TiboLGH/solextronic/hardware/DCDC/DCDC.png

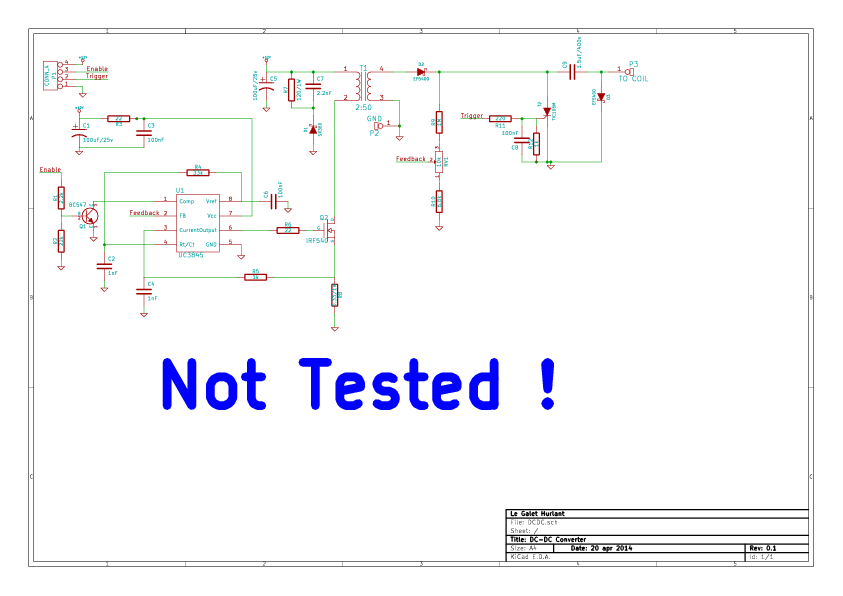
hardware/DCDC/DCDC.png
