TiboLGH/solextronic/hardware/DCDC/DCDC_brd.png

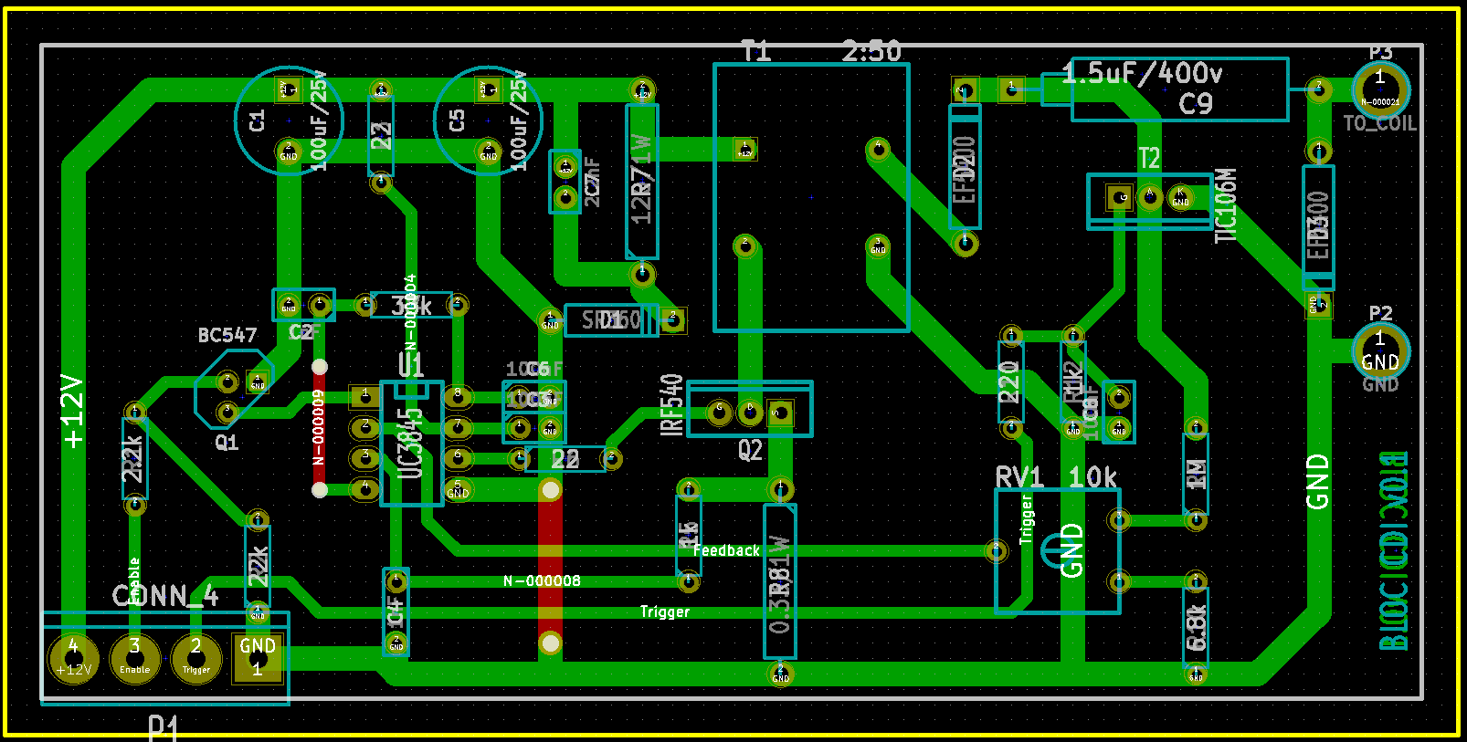
hardware/DCDC/DCDC_brd.png
