TiboLGH/solextronic/hardware/harness/harness.png

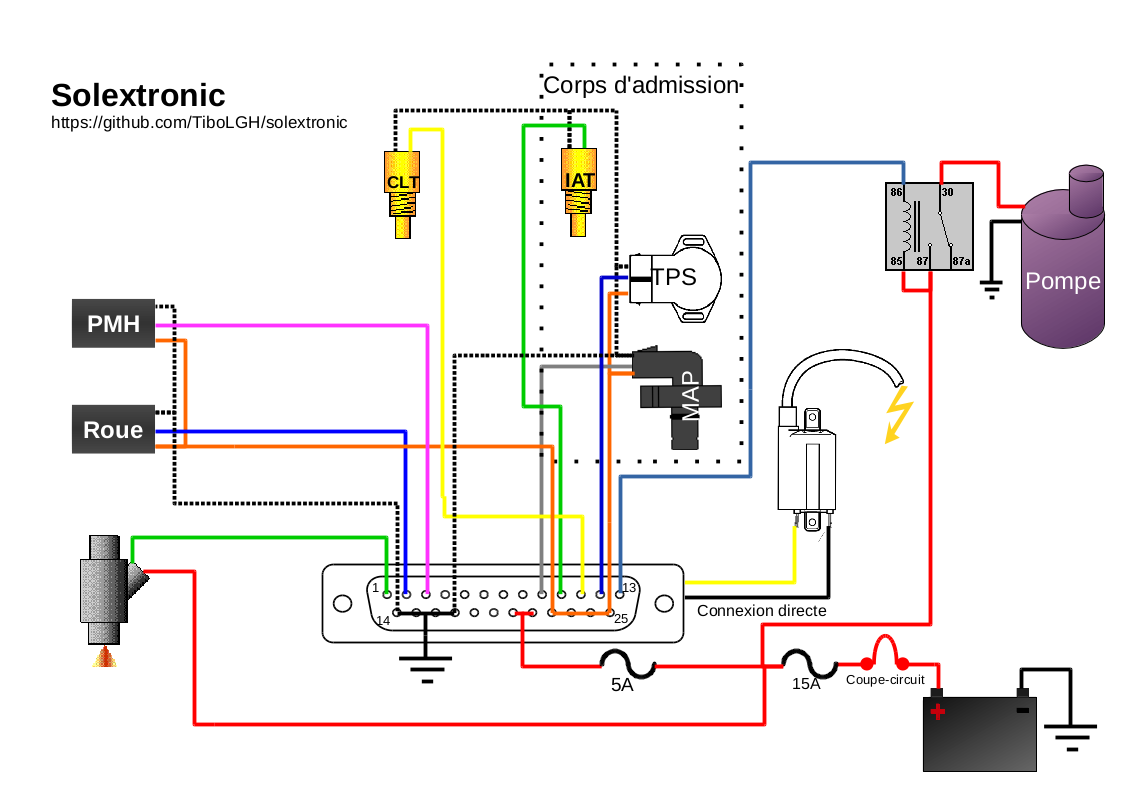
hardware/harness/harness.png
