TiboLGH/solextronic/hardware/solextronic.png

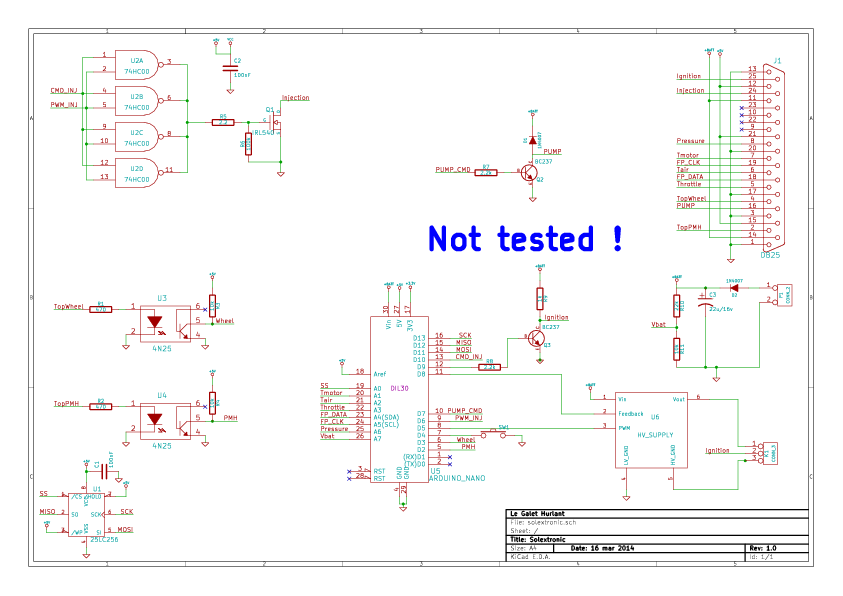
hardware/solextronic.png
