TiboLGH/solextronic/hardware/testBoard/testBoard.png

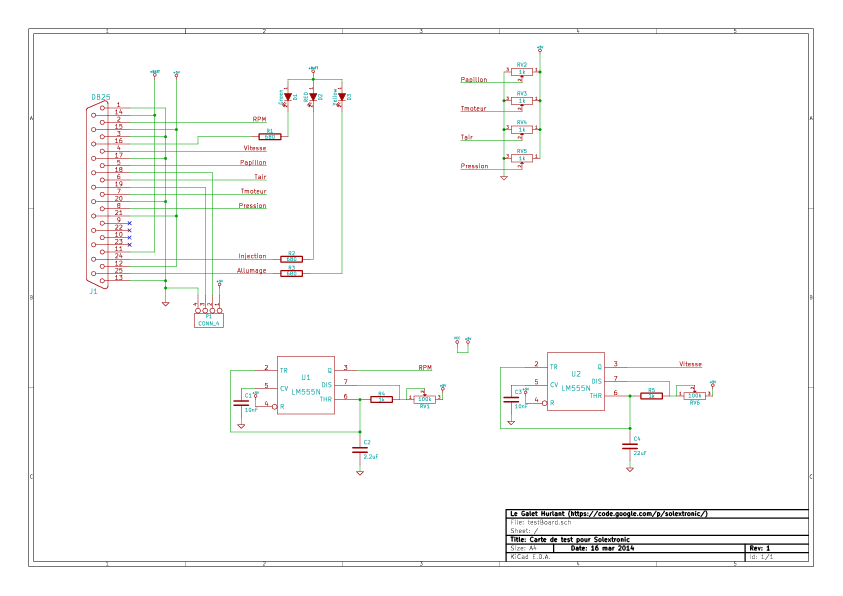
hardware/testBoard/testBoard.png
