TiboLGH/solextronic/(threads)

Thread 10 (2015-03-29):

Gestion des sorties injection/allumage avec un timing fixe

GoogleCodeExporter, 2015-03-29:
```
Dans le FW + test unitaire.

```

Original issue reported on code.google.com by `thibault...@gmail.com` on 18 Mar 2014 at 9:27

TiboLGH, 2015-08-07:
Done dans la version 0.2

Closed 2015-08-07.

Thread 17 (2015-03-29):

Support table de calibration temperature/pression

GoogleCodeExporter, 2015-03-29:
```
Pour supporter les capteurs de temperature de type CTN et le capteur de
pression, des tables de calibration doivent être gérées.

```

Original issue reported on code.google.com by `thibault...@gmail.com` on 11 Aug 2014 at 7:24

TiboLGH, 2015-06-14:
Done dans la rev edfa91a1de388214968415188e47ac5c28c51b85

Closed 2015-06-14.

Thread 18 (2015-03-29):

Support bornes/interpolation papillon

GoogleCodeExporter, 2015-03-29:
```
Pour supporter les variations du papillon, il faut supporter :
 - borne min
 - borne max
 - conversion tension -> 0-100%
 - detection plein gaz, ralenti

```

Original issue reported on code.google.com by `thibault...@gmail.com` on 11 Aug 2014 at 7:28

Closed 2015-07-06.

Thread 5 (2015-03-29):

Gestion centrale des conversions ADC

GoogleCodeExporter, 2015-03-29:
```
Indispensable pour le capteur de pression

```

Original issue reported on code.google.com by `thibault...@gmail.com` on 27 Jan 2014 at 9:12

Closed 2015-07-12.

Thread 9 (2015-03-29):

Schema du faisceau

GoogleCodeExporter, 2015-03-29:
```
+ carte d'adaptation analogique

```

Original issue reported on code.google.com by `thibault...@gmail.com` on 18 Mar 2014 at 9:23

TiboLGH, 2015-06-14:
Finalement, pas de carte d'adaptation analogique, on fait tout sur la carte principale.

TiboLGH, 2015-07-12:
commit c8f4fc2ebacf81f8e0f9d55c82d7b0f48d196261

Closed 2015-07-12.

Thread 21 (2015-07-12):

Gestion de la pompe a essence

TiboLGH, 2015-07-12:
La pompe doit être mise en route a l'appui sur le bouton de starter.
Elle se coupe sur les etats "calé" et "erreur".

TiboLGH, 2015-07-12:
commit f1423a43062c2caa1402921be4e6de4ca2cbf5d0

Closed 2015-07-12.

Thread 22 (2015-07-13):

Gestion du decalage capteur de PMH

TiboLGH, 2015-07-13:
Le code actuel suppose que le capteur de PMH est situé à 0 deg (parfaitement aligné avec le PMH). Pour faciliter l'installation, il est utile de pouvoir choisir le decalage de ce point PMH.

Thread 24 (2015-07-14):

Correction du dead time en fct de la tension de la batterie

TiboLGH, 2015-07-14:

Thread 25 (2015-08-03):

SIM define à la compilation

TiboLGH, 2015-08-03:
Certaines partie du FW ne sont pas (encore ?) simulables et doivent être désactivées et/ou simplifiées pour la simulation.
Exemple :
  * front panel sur I2C

TiboLGH, 2015-08-09:
Fix 539f6951e07a30fcd5a575639abae710855d7ce5

Closed 2015-08-09.

Thread 27 (2015-08-04):

Filtre fausse detection impulsion PMH

TiboLGH, 2015-08-04:
L'ensemble des timings d'injection et d'allumage reposent sur le signal de PMH (trigger). Il est donc fondamental que les eventuelles fausses detection soient filtrees.
Algo possible : la variation de periode d'un cycle à l'autre doit être inférieure à xx% de la durée du cycle (xx =20% pour commencer).

Thread 30 (2015-08-09):

Reparer la simulation

TiboLGH, 2015-08-09:
En incluant les tests auto:
 - ADC
 - test injection

TiboLGH, 2016-01-24:
Fixed e7e3c1fc556e9b67879100c116641bf804bb0966

Closed 2016-01-24.

Thread 31 (2016-01-27):

Nouveau test : demarrage complet

TiboLGH, 2016-01-27:
Pour ce test, on chercher à vérifier :
1/ Démarrage : verif alim HT et pompe
2/ cranking mode : timing injection/allumage au cranking en incluant les corrections temp/batterie
3/ passage en mode running : evolution des corrections + timing à chaque cycle

Thread 33 (2016-05-14):

Generation fichier VCD sur les structures eData et curData

TiboLGH, 2016-05-14:
Pour pouvoir tracer les structures eData (settings) et curData (etat courants) dans un fichier VCD avec la meme date de ref que le fichier VCD de la simultation.
Besoin également de pouvoir tracer des variables internes à la simulation (test number, steps...)

Closed 2016-06-05.

Thread 35 (2016-06-05):

SIM Gestion de l'UART dans un thread independant

TiboLGH, 2016-06-05:
Pour permettre une meilleure gestion des acces a l'uart dans la simulation.
3 taches:
 1/ main
 2/ thread simavr de la simulation
 3/ Acces UART

Les acces UART seront bloquants (+ timeout) pour le thread main + scheduler interne au thread UART pour faire des requetes en boucles.

Closed 2016-06-13.

Thread 37 (2016-12-14):

SIM - Systeme de logging centralise

TiboLGH, 2016-12-14:
Avec les features suivantes:
 - activation par modules
 - timestamp
 - niveaux debug, info, warning, error
 - redirection vers fichier txt
 - basé sur une seule interface

Exemple (C++) : http://www.drdobbs.com/cpp/logging-in-c/201804215?pgno=1

TiboLGH, 2016-12-30:
manque les timestamps

Thread 39 (2021-09-28):

Bonjour cher Français

AmesisProject, 2021-09-28:
Salut M. Je vien de tomber sur ton git. Je pense que nous avons a discuter tout les deux. Je fait un projet dans l'idée du tiens. mais je ne sais pas comment te contacter mise a par ici.
