TiboLGH/solextronic/hardware/solextronic.pdf

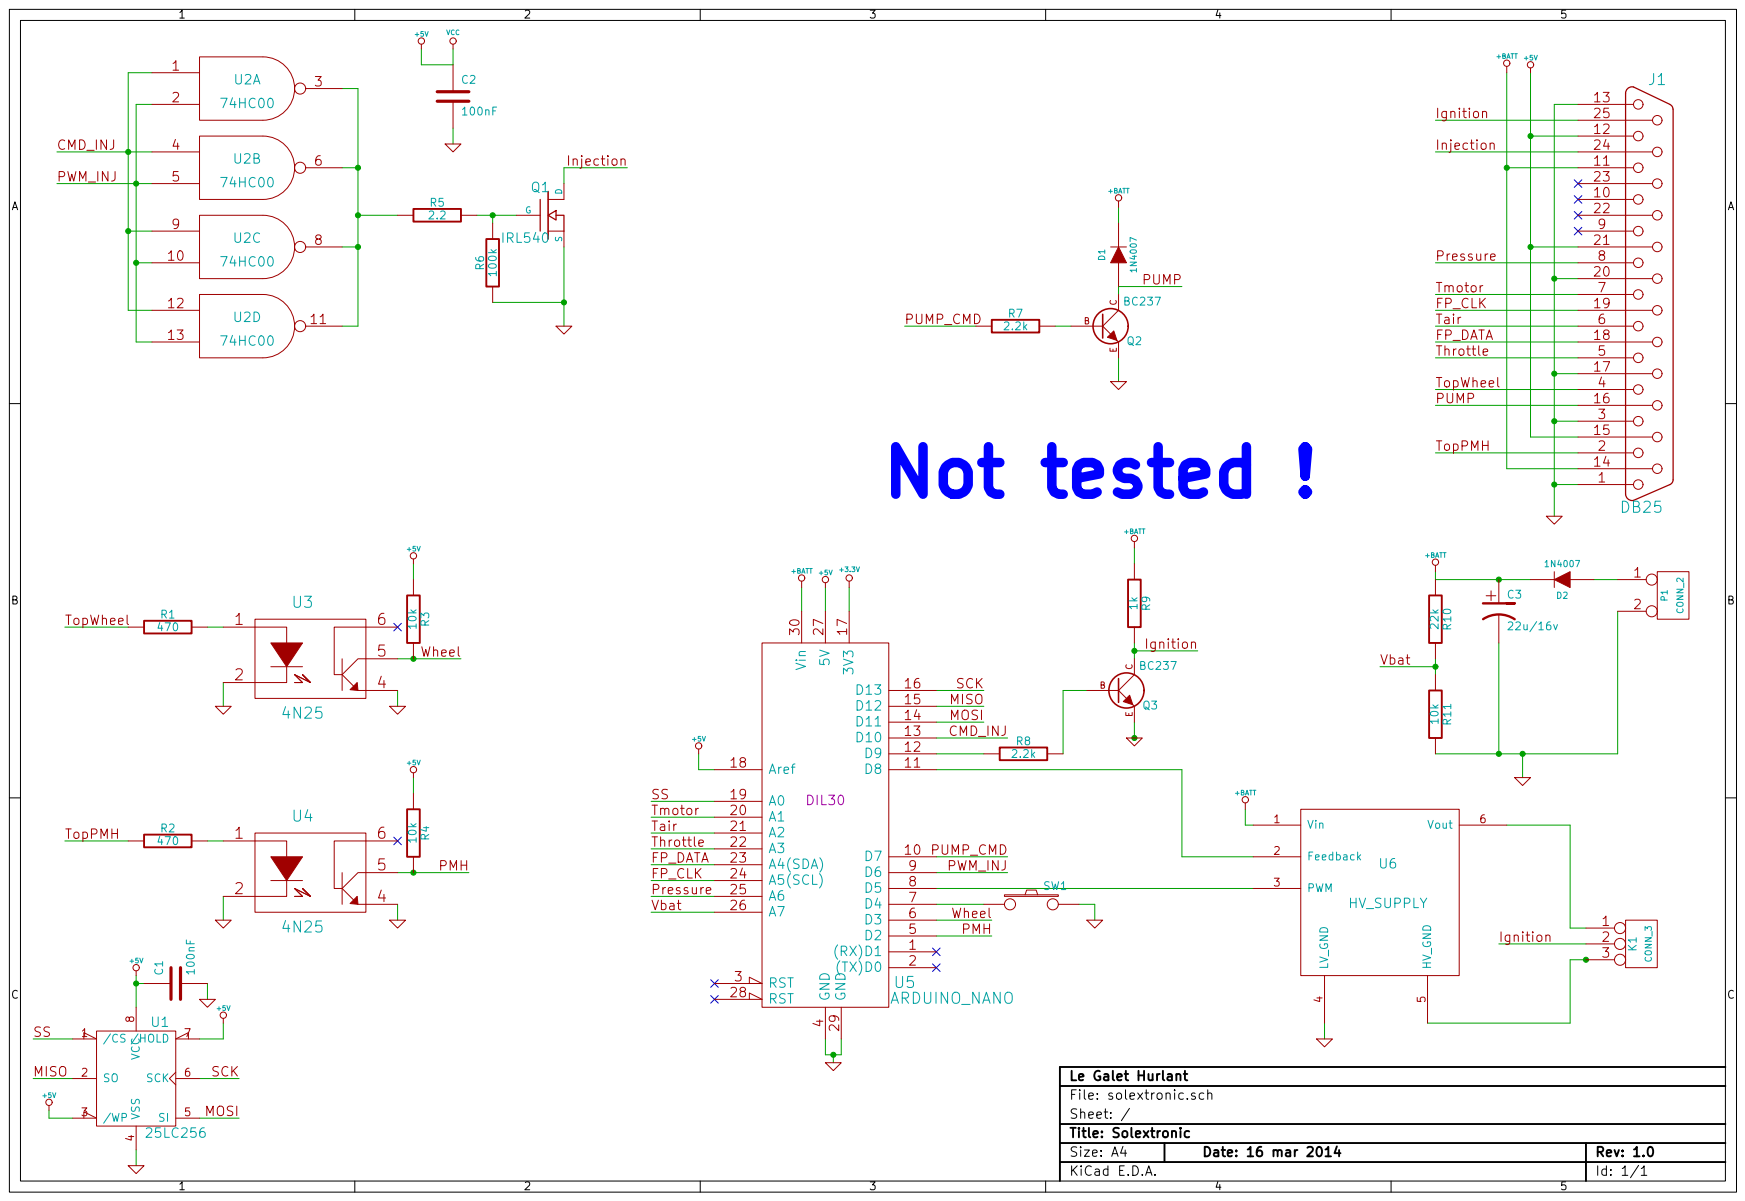
[picture p6: page 1]
