TiboLGH/solextronic/hardware/DCDC/DCDC.pdf

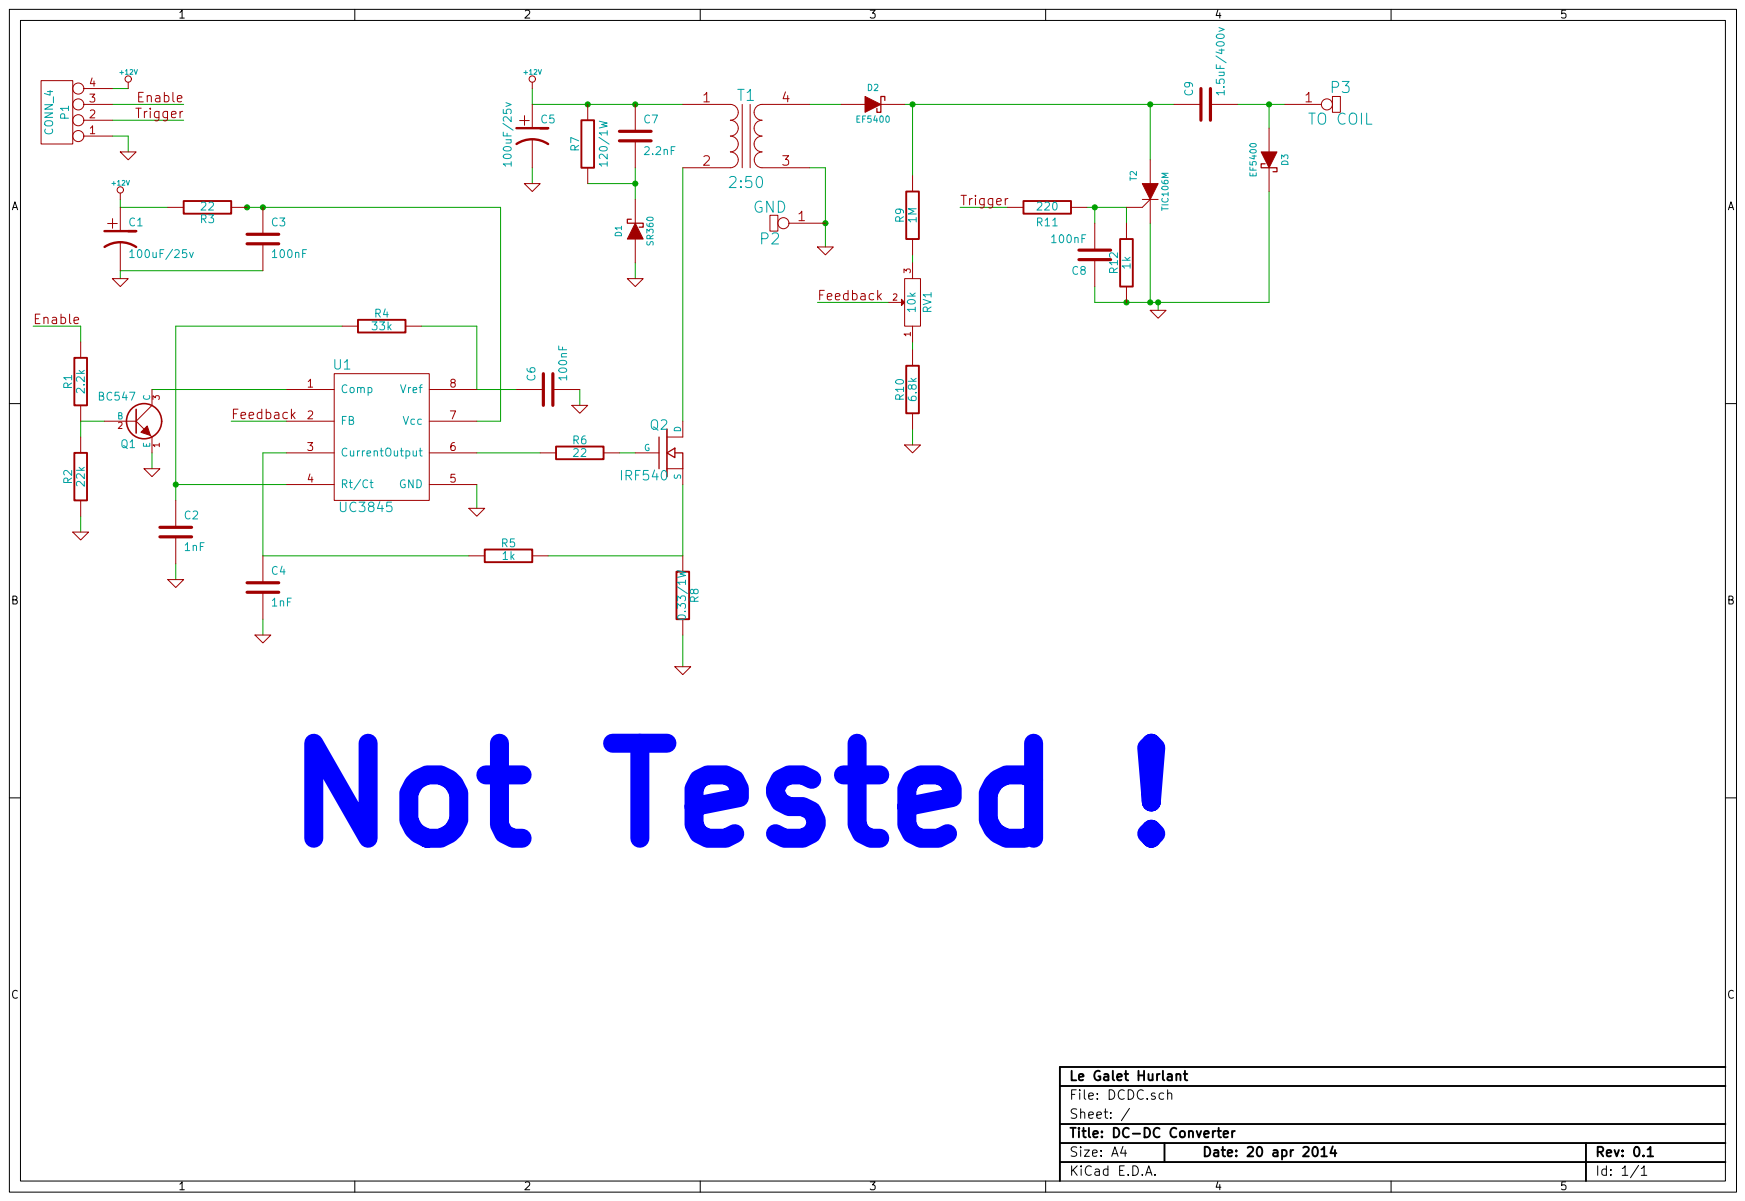
[picture p7: page 1]
