TiboLGH/solextronic/hardware/testBoard/testBoard.pdf

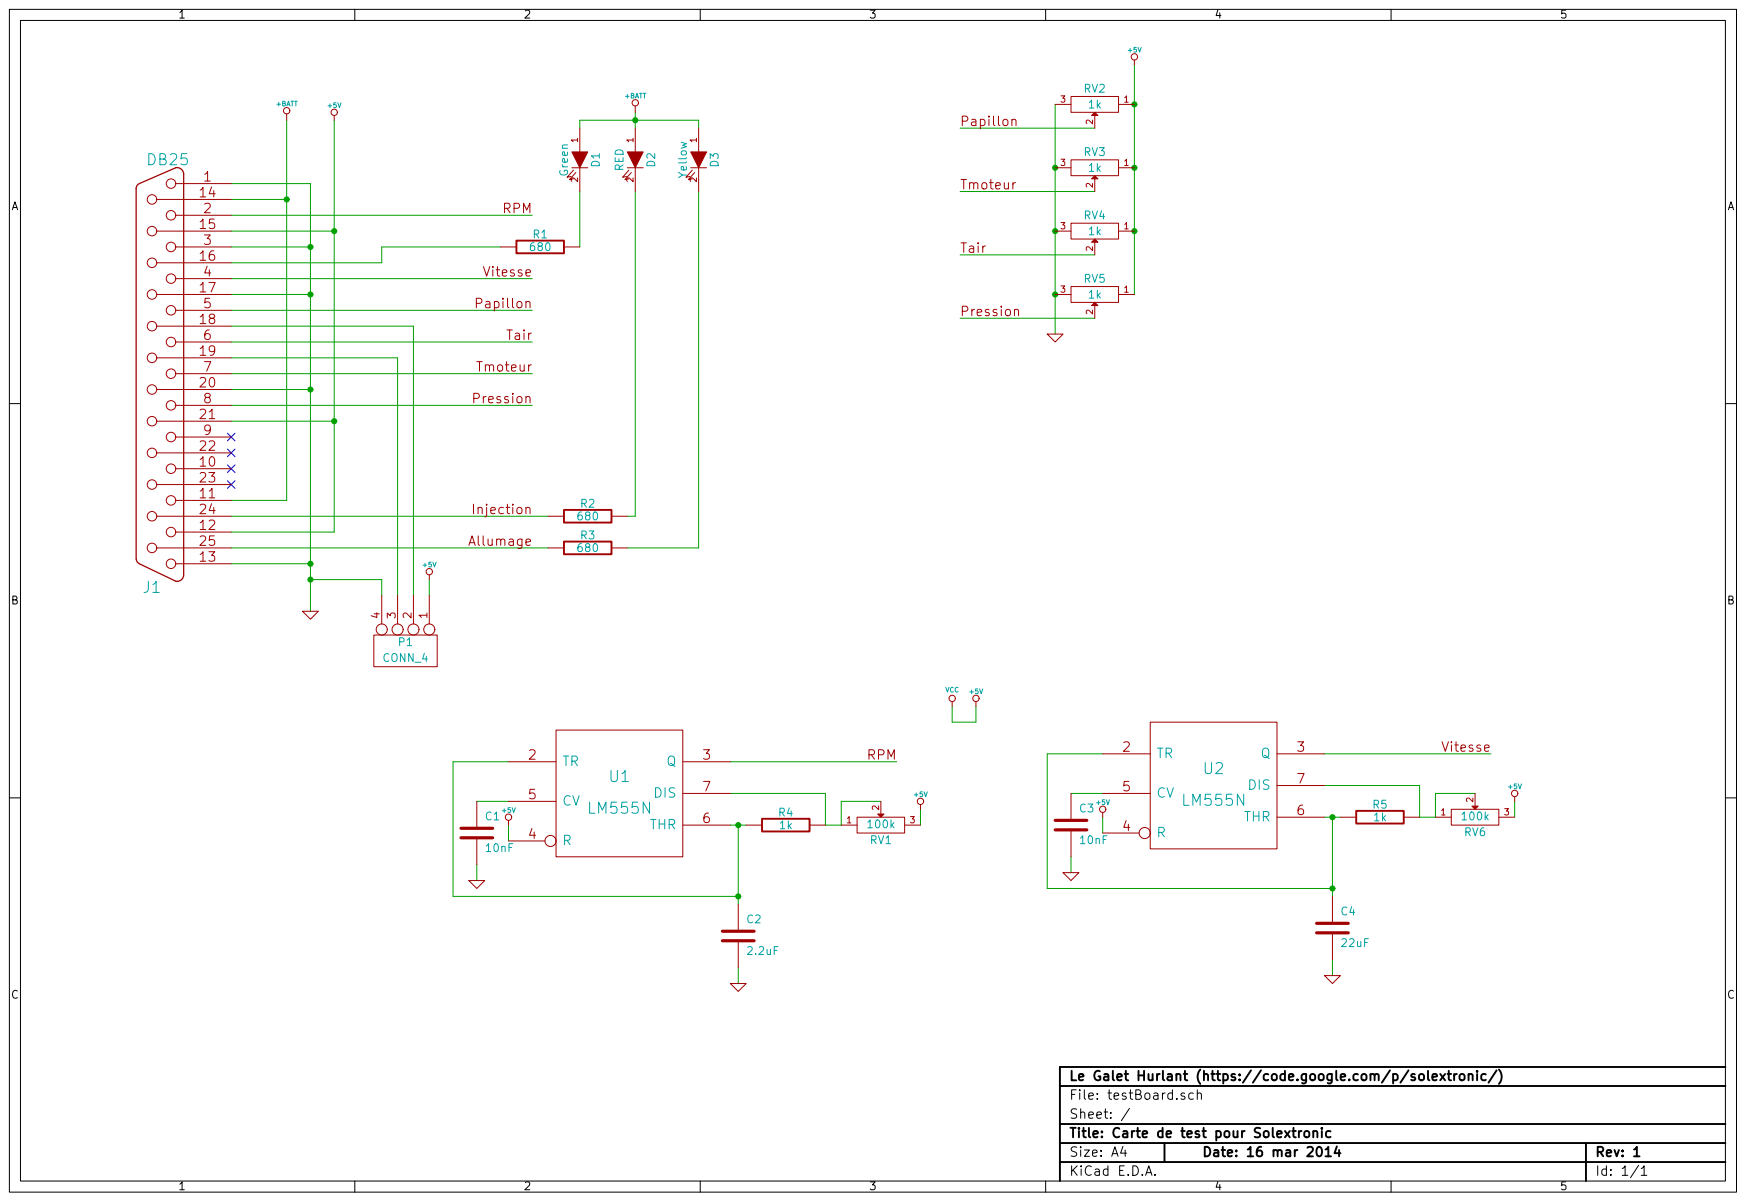
[picture p8: page 1]
