TiboLGH/solextronic/hardware/solextronic.kicad_pcb

## KiCad design hardware/solextronic.kicad_pcb (2015-03-29)

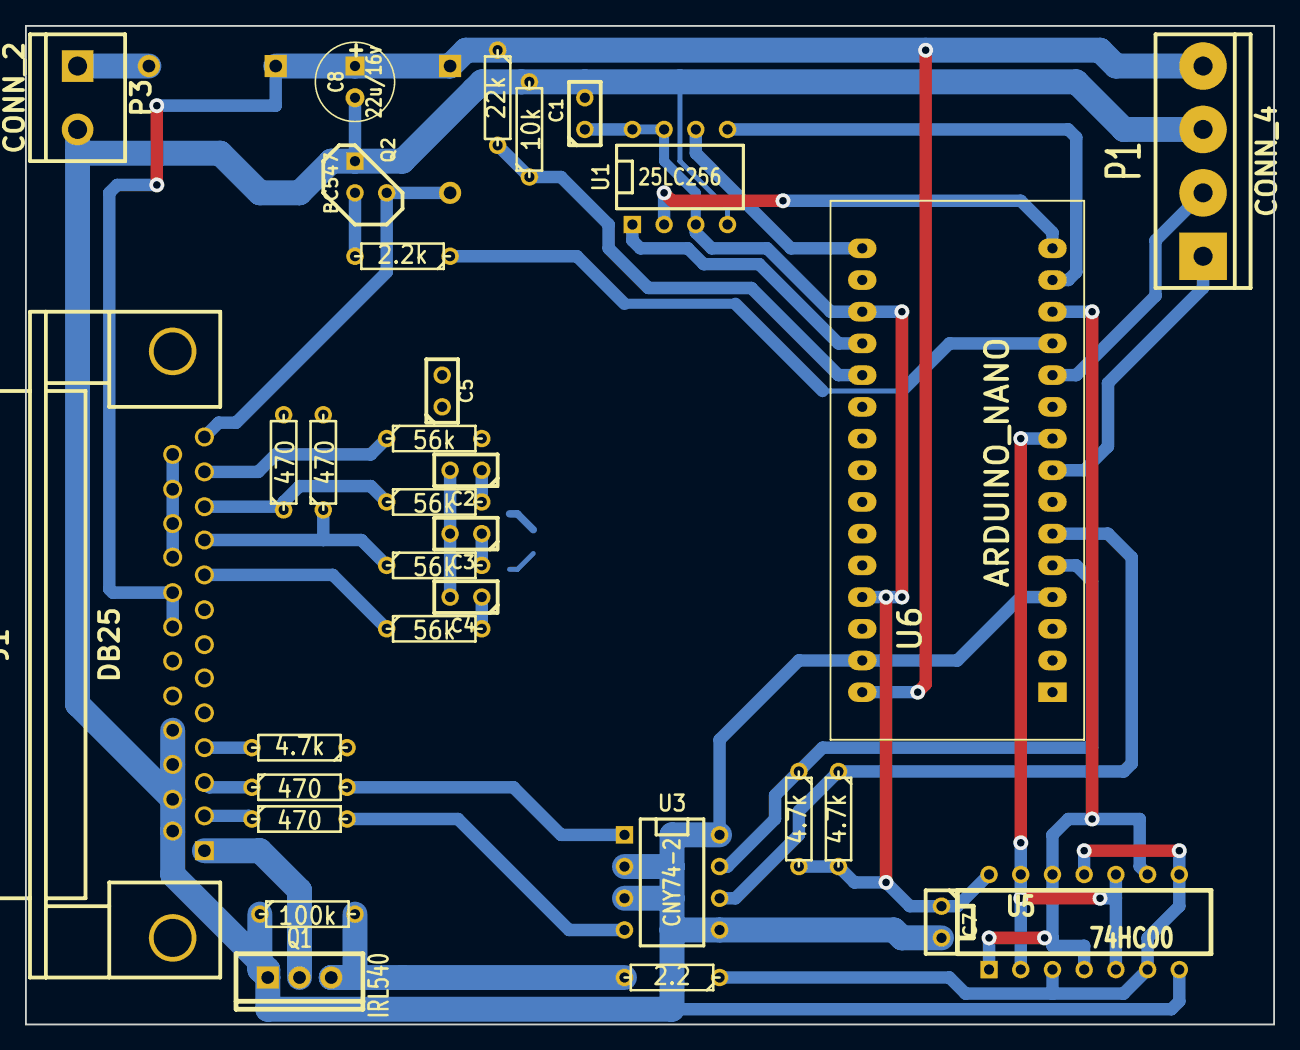
[picture p9: board solextronic.kicad_pcb from above]

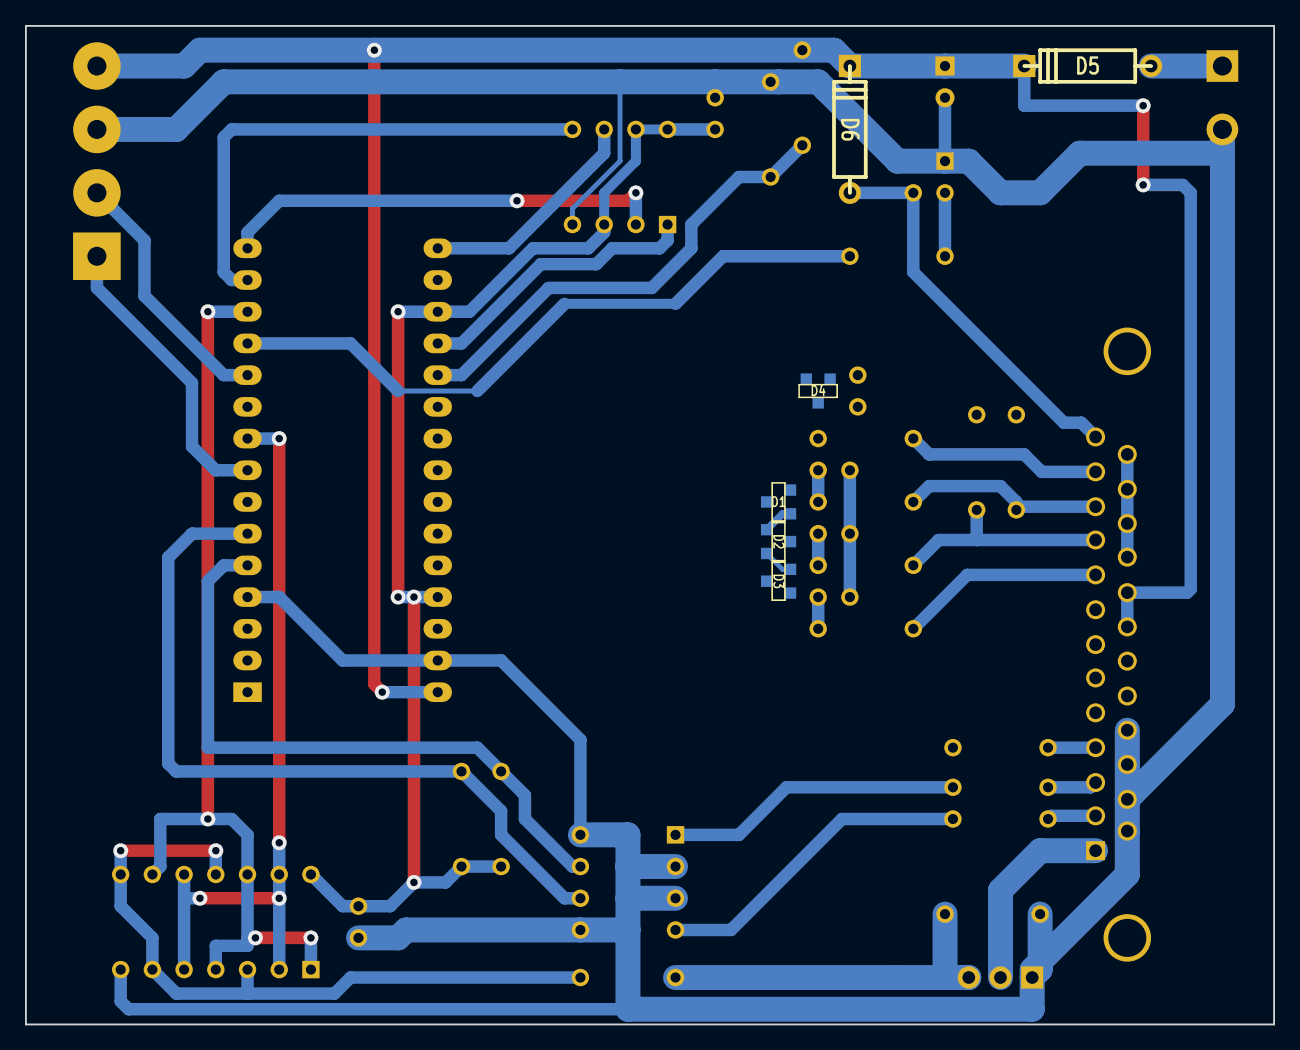
[picture p10: board solextronic.kicad_pcb from below]

Board: 2 copper layers, 100.0 x 80.0 mm, 38 parts (6 on the bottom side), 37 nets.

Parts:
C1, C2, C3, C4, C5, C7: 100nF; C1
C8: 22u/16v; C1V7
D1, D2, D3, D4: BAT54S; ST23AK#1
D5, D6: 1N4007; D4
J1: DB25; DB25FC
P1: CONN_4; bornier4
P3: CONN_2; bornier2
Q1: IRL540; TO220_VERT_GDS
Q2: BC547; TO92-EBC
R1, R3, R4, R16: 56k; R3
R2, R5, R6, R15: 470; R3
R7, R8, R11: 4.7k; R3
R9: 2.2; R3
R10: 100k; R3
R12: 22k; R3
R13: 10k; R3
R14: 2.2k; R3
U1: 25LC256; DIP-8__300
U3: CNY74-2; DIP-8__300
U5: 74HC00; DIP-14__300
U6: ARDUINO_NANO; arduino_nano

Connections:
+5V: C1.1, C7.1, D1.3, D2.3, D3.3, D4.3, J1.22, J1.23, J1.24, J1.25, R2.2, R7.2, R8.2, R11.1, R15.2, U1.3, U1.7, U1.8, U5.14, U6.18, U6.27
+BATT: C8.1, D5.2, D6.2, J1.20, J1.21, P1.4, R12.1, U6.30
/AUX1: J1.5, U6.10
/BTN1: J1.4, R11.2, U6.7
/CLT: J1.11, R1.1, R15.1
/CLTAdc: C2.1, D1.2, R1.2, U6.22
/CMD_INJ: U5.1, U5.4, U5.9, U5.12, U6.13
/EnableHV: P1.1, U6.8
/FP_CLK: J1.7, U6.24
/FP_DATA: J1.8, U6.23
/IAT: J1.10, R2.1, R3.1
/IATAdc: C3.1, D2.2, R3.2, U6.25
/Ignition: J1.6, P1.2, U6.11
/Injection: J1.1, Q1.D
/MAP: J1.9, R4.1
/MAPAdc: C4.1, D3.2, R4.2, U6.26
/MISO: U1.2, U6.15
/MOSI: U1.5, U6.14
/Motor: R8.1, U3.7, U6.5
/PUMP: D6.1, J1.13, Q2.C
/PUMP_CMD: R14.1, U6.12
/PWM_INJ: U5.2, U5.5, U5.10, U5.13, U6.9
/SCK: U1.6, U6.16
/SS: U1.1, U6.19
/TPS: J1.12, R16.1
/TPSAdc: C5.1, D4.2, R16.2, U6.21
/TopMotor: J1.3, R6.1
/TopWheel: J1.2, R5.1
/Vbat: R12.2, R13.1, U6.20
/Wheel: R7.1, U3.6, U6.6
GND: C1.2, C2.2, C3.2, C4.2, C5.2, C7.2, C8.2, D1.1, D2.1, D3.1, D4.1, J1.14, J1.15, J1.16, J1.17, P1.3, P3.2, Q1.S, Q2.E, R10.1, R13.2, U1.4, U3.2, U3.3, U3.5, U3.8, U5.7, U6.4, U6.29
unnamed: R9.1, U5.3, U5.6, U5.8, U5.11
unnamed: R6.2, U3.1
unnamed: D5.1, P3.1
unnamed: Q2.B, R14.2
unnamed: R5.2, U3.4
unnamed: Q1.G, R9.2, R10.2
