TiboLGH/solextronic/hardware/solextronic.sch

## KiCad design hardware/solextronic.sch (2015-07-19, an earlier design)

Schematic: solextronic.sch

Parts:
C1, C7: 100nF
C2, C3, C4, C5: 100nF
C8: 22u/16v
D1, D2, D3, D4: BAT54S
D5, D6: 1N4007
J1: DB25
P1, P2: CONN_4
P3: CONN_2
Q1: IRL540
Q2: BC547; TO92-EBC
R1, R2, R3: 56k
R4: 5.6k
R5, R6: 470
R7, R8, R11: 4.7k
R9: 2.2
R10: 100k
R12: 22k
R13: 10k
R14: 2.2k
R15, R16: 470
U1: 25LC256
U2: LM324
U3: CNY74-2
U5: 74HC00
U6: ARDUINO_NANO; DIL30

Notes on the sheet:
Not tested !
