TiboLGH/solextronic/hardware/DCDC/DCDC.sch

## KiCad design hardware/DCDC/DCDC.sch (2015-10-24, an earlier design)

Schematic: DCDC.sch

Parts:
C1, C5: 100uF/25v; C2V8
C2: 1nF; C1
C3, C6, C8: 100nF; C1
C4: 1nF; C2
C7: 2.2nF; C1
C9: 1.5uF/400v; CP10
D1: SR360; D4
D2, D3: EF5400; D5
P1: CONN_4; bornier4
P2: GND; 1pin
P3: TO COIL; 1pin
Q1: BC547; TO92
Q2: IRF540; TO220_VERT_GDS
R1: 2.2k; R3
R2: 22k; R3
R3, R6: 22; R3
R4: 33k; R3
R5, R12: 1k; R3
R7: 120/1W; R6
R8: 0.33/1W; R6
R9: 1M; R3
R10: 6.8k; R3
R11: 220; R3
RV1: 10k; POT
T1: 2:50; TRANSFO
T2: TIC106M; TIC106
U1: UC3845; DIP-8__300_ELL

Notes on the sheet:
Not Tested !
