TiboLGH/solextronic/hardware/testBoard/testBoard.sch

## KiCad design hardware/testBoard/testBoard.sch (2015-06-14, an earlier design)

Schematic: testBoard.sch

Parts:
C1, C3: 10nF
C2: 2.2uF
C4: 22uF
D1: Green
D2: RED
D3: Yellow
J1: DB25
P1: CONN_4
R1, R2, R3: 680
R4, R5: 1k
RV1, RV6: 100k
RV2, RV3, RV4, RV5: 1k
U1, U2: LM555N
