TiboLGH/solextronic/firmware/test/simMain.c

/***************************************************************************
 *   Copyright (C) 2013 by Thibault Bouttevin                              *
 *   thibault.bouttevin@gmail.com                                          *
 *   www.legalethurlant.fr.st                                              *
 *                                                                         *
 *   This file is part of SolexTronic                                      *
 *                                                                         *
 *   SolexTronic is free software; you can redistribute it and/or modify   *
 *   it under the terms of the GNU General Public License as published by  *
 *   the Free Software Foundation; either version 3 of the License, or     *
 *   any later version.                                                    *
 *                                                                         *
 *   This program is distributed in the hope that it will be useful,       *
 *   but WITHOUT ANY WARRANTY; without even the implied warranty of        *
 *   MERCHANTABILITY or FITNESS FOR A PARTICULAR PURPOSE.  See the         *
 *   GNU General Public License for more details.                          *
 *                                                                         *
 *   You should have received a copy of the GNU General Public License     *
 *   along with this program; if not, write to the                         *
 *   Free Software Foundation, Inc.,                                       *
 *   59 Temple Place - Suite 330, Boston, MA  02111-1307, USA.             *
 ***************************************************************************/
 /**
 * \file simMain.c
 * \brief Main file of the simulation
 * \author Thibault Bouttevin
 * \date June 2013
 *
 * This file includes the test scheduler and simaulation core based on simavr
 *
 */

#include <stdlib.h>
#include <stdio.h>
#include <libgen.h>
#include <string.h>
#include <stdbool.h>
#include <unistd.h>
#include <termios.h>
#include <ctype.h>
#include <sys/fcntl.h>
#include <pthread.h>

#include "sim_avr.h"
#include "avr_ioport.h"
#include "avr_timer.h"
#include "avr_adc.h"
#include "sim_elf.h"
#include "sim_gdb.h"
#include "sim_vcd_file.h"
#include "sim_irq.h"
#include "sim_time.h"

#include "uart_pty.h"
#include "pulse_input.h"
#include "analog_input.h"
#include "timing_analyzer.h"
#include "sim_helpers.h"
#include "trace_writer.h"
#include "push_button.h"
#include "logger.h"

#include "../varDef.h"
#include "../helper.h"
#include "../../model/model.h"

const char *ptyName = "/tmp/simavr-uart0";
#define RPM_QTY 5
#define SPEED_QTY 5
#define RETRY_SERIAL 3

#define RED(msg, ...) fprintf(stdout, "\033[31m" msg "\033[0m", ##__VA_ARGS__ )
#define GREEN(msg, ...) fprintf(stdout, "\033[32m" msg "\033[0m", ##__VA_ARGS__ )
#define HIGH(msg, ...) fprintf(stdout, "\033[1m" msg "\033[0m", ##__VA_ARGS__ )
#define V(msg, ...) if(_verbose) fprintf(stdout, msg, ##__VA_ARGS__ )

enum{
    MANUAL = 0,
    ALL_TEST,
    ONE_TEST,
    LIST_TEST,
};

enum{
    TEST_VERSION,
    TEST_RPM,
    TEST_SPEED,
    TEST_ANALOG,
    TEST_IGNTESTMODE,
    TEST_INJTESTMODE,
    TEST_TIMING,
    TEST_STARTING,
    TEST_QTY
};

enum{
    ERROR = 0,
    OK = 1,
    FAIL,
    PASS,
    NOTEST
};

typedef struct{
    int id;
    char name[256];
    int (*testFunction)(void);
}Test_t;

/*********************************
 * Thread architecture
 * 
 * 3 threads are used:
 *  1/ main fct as main thread driving the tests
 *  2/ simavr core simulation running in avr_run_thread() function
 *  3/ UART access tread running in uart_thread() function
 */

avr_t * avr = NULL;
avr_vcd_t vcd_file;
trace_writer_t vcd_trace;
int logHandle = -1;
uart_pty_t uart_pty;
pulse_input_t pulse_input_engine;
pulse_input_t pulse_input_wheel;
timing_analyzer_t timing_analyzer_injection;
timing_analyzer_t timing_analyzer_ignition;
analog_input_t analog;
button_t button_cranking;
volatile uint8_t    display_pwm = 0;
int fd = 0; /* access to serial port */
/* Thread messaging structure and shared variables */
typedef struct 
{
    eeprom_data_t    eData, eDataToWrite;
    current_data_t   gState;
    u8               signature[32];
    u8               revision[20];

    bool edata_read_request;
    bool edata_write_request;
    bool curdata_read_request;
    bool signature_read_request;
    bool continuous_mode;
    int status;

    pthread_mutex_t mutex_edata;
    pthread_cond_t  cond_uart_request;
    pthread_cond_t  cond_read_current_data;
    pthread_cond_t  cond_read_signature;
    pthread_cond_t  cond_write_edata;
    pthread_cond_t  cond_read_edata;
}uart_com_t;
static uart_com_t uart_com =
{
    .edata_read_request         = false,
    .edata_write_request        = false,
    .continuous_mode            = false,
    .curdata_read_request       = false,
    .signature_read_request     = false,
    .status                     = OK,   
    .mutex_edata                = PTHREAD_MUTEX_INITIALIZER,
    .cond_uart_request          = PTHREAD_COND_INITIALIZER,
    .cond_read_current_data     = PTHREAD_COND_INITIALIZER,
    .cond_read_signature        = PTHREAD_COND_INITIALIZER,
    .cond_write_edata           = PTHREAD_COND_INITIALIZER,
    .cond_read_edata            = PTHREAD_COND_INITIALIZER,
};

bool             _verbose = false;
bool             _wave    = false;

/* Forward declaration */
int TestVersion(void);
int TestRPM(void);
int TestSpeed(void);
int TestAnalog(void);
int TestIgnitionTestMode(void);
int TestInjectionTestMode(void);
int TestIgnInjTiming(void);
int TestStarting(void);
int TestStub(void);

int testQty;
Test_t testList[] = {
    {TEST_VERSION,      "Version",          TestVersion},
    {TEST_RPM,          "RPM",              TestRPM},
    {TEST_SPEED,        "Speed",            TestSpeed},
    {TEST_ANALOG,       "Analog",           TestAnalog},
    {TEST_IGNTESTMODE,  "IgnitionTest",     TestIgnitionTestMode},
    {TEST_INJTESTMODE,  "InjectionTest",    TestInjectionTestMode},
    {TEST_TIMING,       "Timing",           TestIgnInjTiming},
    {TEST_STARTING,     "Starting",         TestStarting},
};

/********* Helpers ************/
static void RPMtoPeriod(const uint32_t rpm, uint32_t *tHigh, uint32_t *tLow)
{
    *tHigh = 100; /* set high duration to 100us */
    if(rpm == 0)
        *tLow =0;
    else
        *tLow  = (uint32_t)(1000000. / (rpm / 60.) - *tHigh);
}

static void SpeedtoPeriod(const uint32_t speed, uint32_t *tHigh, uint32_t *tLow)
{
    *tHigh = 1000; /* set high duration to 1ms */
    if(speed == 0)
        *tLow =0;
    else
        *tLow  = 1000000 / (speed / 3.6 / 1.82) - *tHigh; /* 1.82m : for 19" wheel */
}

static float BatToVoltage(const float battery)
{
    return ((battery-7) / 30.);  //-0.7 for protection diode, BattRatio shall be set to 150
}

enum {IAT = 0, CLT};

static float TempToVoltage(const float degree, int type, eeprom_data_t *eData) // 0 IAT, 1 CLT
{
    // Reverse table to get adc value vs temp
    volatile u8 tempTable[TABSIZE][2];
    for(int i=0; i < TABSIZE; i++)
    {
        tempTable[TABSIZE-1 - i][0] = (type == IAT) ? eData->iatCal[i][1] : eData->cltCal[i][1];
        tempTable[TABSIZE-1 - i][1] = (type == IAT) ? eData->iatCal[i][0] : eData->cltCal[i][0];
    }
    u8 adc = Interp1D(tempTable, (u8)degree);
    //u8 temp = Interp1D(eData.iatCal, adc);
    //V("Type %s : %f deg -> %d adc -> %d deg\n", (type == IAT) ? "IAT":"CLT", degree, adc, temp);

    return (adc * 5 / 256.);
}

static float MapToVoltage(const float kpa, eeprom_data_t *eData) // considering linear based on min/max
{
    float voltage = (kpa + eData->map0) * 5 / (eData->map5 - eData->map0) ;
    return voltage;
}

static float ThrToVoltage(const float TPS, eeprom_data_t *eData) // TPS in %
{
    // note that TPS min and max are in ADC unit, not in %
    float adc = (eData->tpsMax - eData->tpsMin) * TPS / 100. + eData->tpsMin;
    float voltage = adc * 5/256.;
    return voltage;
}

typedef struct {
    unsigned int ledPin  : 1; // PB5
    unsigned int auxPin  : 1; // PB0
    unsigned int injPin  : 1; // PB2
    unsigned int ignPin  : 1; // PB1
    unsigned int pumpPin : 1; // PD7
    unsigned int hvPin   : 1; // PD5
}output_t;

// Get outputs states and return it as a bitfield
// if bug is not null, format a pretty print (need at least 256 bytes)
static output_t GetOutputState(char* buf)
{
    output_t state;
	avr_ioport_state_t iostate;
    // port B
    avr_ioctl(avr, AVR_IOCTL_IOPORT_GETSTATE('B'), &iostate);
    state.ledPin = (iostate.pin >> 5) & 0x1;
    state.auxPin = (iostate.pin >> 0) & 0x1;
    state.injPin = (iostate.pin >> 2) & 0x1;
    state.ignPin = (iostate.pin >> 1) & 0x1;
    // port D
    avr_ioctl(avr, AVR_IOCTL_IOPORT_GETSTATE('D'), &iostate);
    state.pumpPin = (iostate.pin >> 7) & 0x1;
    state.hvPin   = (iostate.pin >> 5) & 0x1;
    
    if(buf) // for pretty print
    {
        snprintf(buf, 256, "Led %s, Aux %s, Inj %s, Ign %s, Pump %s, HV %s", state.ledPin?"ON":"OFF",
                                                                             state.auxPin?"ON":"OFF",
                                                                             state.injPin?"ON":"OFF",
                                                                             state.ignPin?"ON":"OFF",
                                                                             state.pumpPin?"ON":"OFF",
                                                                             state.hvPin?"ON":"OFF"); 
    }


    return state;
}

// Engine state pretty print (need to be resynchronize with FW sometimes)
// buffer shall be at least 64 bytes
enum
{
    M_STOP      = 0,
    M_CRANKING  = 1 << 0,
    M_RUNNING   = 1 << 1,
    M_OVERHEAT  = 1 << 2,
    M_ERROR     = 1 << 3,
    M_STALLED   = 1 << 4,
    M_TEST_IGN  = 1 << 5,
    M_TEST_INJ  = 1 << 6,
    M_TEST_RUN  = 1 << 7
};
const char* engineStr[] = {
    "CRANKING",
    "RUNNING",
    "OVERHEAT",
    "ERROR",
    "STALLED",
    "TEST_IGN",
    "TEST_INJ",
    "TEST_RUN",
};
static void EnginePrettyPrint(u8 state, char* buf)
{
    if(state == M_STOP)
    {
        snprintf(buf, 64, "STOP");
    }else{
        // can have several bits active
        buf[0] = '\0';
        for(int i=0;i<8;i++)
        {
            if(buf[0] == '\0')
            {
                if((state >> i) & 1) sprintf(buf, "%s", engineStr[i]);
            }else{
                if((state >> i) & 1) sprintf(buf, "%s | %s", buf, engineStr[i]);
            }
        }
    }
    return;
}

#if 0
static void PrintArray(const u8* buffer, const int len)
{
    char str[1024];
    sprintf(str, "Len : %d, 0x", len);
    for(int i = 0; i < len; i++) sprintf(str, "%s %02X", str, *(buffer + i));
    V("%s\n", str);
    return;
}

static void PrettyPrint(const u8* buffer, const int len)
{
    char str[1024];
    sprintf(str, "Len : %d, 0x", len);
    for(int i = 0; i < len; i++) sprintf(str, "%s %d", str, *(buffer + i));
    V("%s\n", str);
    return;
}
#endif

static float TimingToAdvance(const uint32_t rpm, const uint32_t timing)
{
    // timing in us
    double period = 60e6/rpm; //us
    return (360 - (timing / period) * 360);
}

static bool CheckTolerance(const float result, const float expected, const float tolerance, float *error)
{
    *error = (result-expected);
    if(*error > tolerance || *error < -tolerance) return false;       
    return true;
}

/*********************************************************************/

static int SerialOpen(void)
{
    // from http://www.tldp.org/HOWTO/Serial-Programming-HOWTO/x115.html
    struct termios oldtio,newtio;
    int fd_s = 0;

    fd_s = open(ptyName, O_RDWR | O_NOCTTY ); 
    if (fd_s < 0) {perror(ptyName); exit(-1); }

    tcgetattr(fd_s, &oldtio); /* save current serial port settings */
    bzero(&newtio, sizeof(newtio)); /* clear struct for new port settings */
    newtio.c_cflag = B57600 | CS8 | CLOCAL | CREAD;
    newtio.c_iflag = IGNPAR; // | ICRNL | IGNCR;
    newtio.c_oflag = 0;
    newtio.c_lflag = 0; //ICANON;
    newtio.c_cc[VTIME] = 0; /* inter-character timer unused */
    newtio.c_cc[VMIN]  = 1; /* blocking read until 1 char received */
    tcflush(fd_s, TCIFLUSH);
    tcsetattr(fd_s,TCSANOW,&newtio);
    return fd_s;
}

static int SerialClose(int fd_s)
{
    close(fd_s);
    return OK;
}
/************** Tests definition *****************/
/*********** Basic steps *************/
static int SleepMs(const int delayms)
{
    // use simavr timebase to get sleep time in AVR world
    if(!avr)
	return FAIL;
    
    u32 end = avr->cycle + avr_usec_to_cycles(avr, 1000*delayms);
    //wait for end
    while(avr->cycle < end)
    {
	    usleep(10*1000);
    }
    return OK;
}

/******************************************************
 * UART Access functions
 * UART thread is running in loop with 2 modes:
 *  - on request : current_data are read on demand (through QueryState fct)
 *  - contnuous : current_data are read in loop (and traced if enabled), 
 *  QueryState fct return the last cached value
 * eData read/write access are done on request only
 * ****************************************************/

static void SetUartMode(uart_com_t *uart, bool continuous)
{
    pthread_mutex_lock(&uart->mutex_edata);
    uart->continuous_mode = continuous;
    pthread_mutex_unlock(&uart->mutex_edata);
}

static int ReadFromSerial(const int nbToRead, u8 *dst)
{
    int res, nbRead = 0;
    u8 buffer[512];
    struct timeval timeout;
    fd_set readfs;

    SleepMs(200);
    timeout.tv_usec = 0;
    timeout.tv_sec  = 1;
    FD_SET(fd, &readfs);
    while(nbRead < nbToRead)
    {
        res = select(fd + 1, &readfs, NULL, NULL, &timeout);
        if ((res == 0) || (!FD_ISSET(fd, &readfs))) /* number of file descriptors with input = 0, timeout occurred. */
        {
            RED("Serial link timeout !\n");
            return FAIL;
        }else{ /* read answer */
            res = read(fd, buffer + nbRead, 255);
            nbRead += res;
            //V("<< res, NbRead : %d, %d\n", res, nbRead);
            //SleepMs(20);
        }
    }
    // buffer fully read : copy to target
    memcpy(dst, buffer, nbToRead);
    //HIGH("ReadFromSerial :\n");
    //PrintArray(buffer, nbToRead);
    return OK;
}

// read config set into toRead
static int ReadConfig(uart_com_t *uart, eeprom_data_t *toRead)
{
    int res;

    pthread_mutex_lock(&(uart->mutex_edata));
    // set flag and wait for reply 
    uart->edata_read_request = true;
    pthread_cond_signal(&(uart->cond_uart_request));
    pthread_cond_wait(&(uart->cond_read_edata), &(uart->mutex_edata));
    res = uart->status;
    if(res == OK)
    {
        memcpy(toRead, &(uart->eData), sizeof(eeprom_data_t));
    }
    pthread_mutex_unlock(&(uart->mutex_edata));
    if(res != OK) return FAIL;
    return OK;
}

// write config set in toWrite
static int WriteConfig(uart_com_t *uart, eeprom_data_t *toWrite)
{
    int res;
    pthread_mutex_lock(&(uart->mutex_edata));
    // set flag and wait for reply
    memcpy(&(uart->eDataToWrite), toWrite, sizeof(eeprom_data_t)); 
    uart->edata_write_request = true;
    pthread_cond_signal(&(uart->cond_uart_request));
    pthread_cond_wait(&(uart->cond_write_edata), &(uart->mutex_edata));
    res = uart->status;
    pthread_mutex_unlock(&(uart->mutex_edata));
    if(res != OK) return FAIL;
    return OK;
}

static void *uart_thread(void * param)
{
    uart_com_t *uart = (uart_com_t*) param;

    while(1)
    {
        // wait for external request
        pthread_mutex_lock(&(uart->mutex_edata));
        if(!uart->continuous_mode) pthread_cond_wait(&(uart->cond_uart_request), &(uart->mutex_edata));
        //V("UART: Request to thread\n");
        if(uart->curdata_read_request || uart->continuous_mode)
        {
            //V("get current data\n");
            write(fd, "a", 1);
            uart->status = ReadFromSerial(sizeof(current_data_t), (u8*)&(uart->gState));
            if(uart->status == OK) trace_writer_update_curData(&vcd_trace, &(uart->gState)); // trace changes
            if(uart->curdata_read_request)
            {   
                uart->curdata_read_request = false;
                pthread_cond_signal(&(uart->cond_read_current_data));
            }
        }

        if(uart->signature_read_request)
        {
            //V("get signature\n");
            //V(">> S\n");
            write(fd, "S", 1);
            uart->status = ReadFromSerial(32, uart->signature);
            if(uart->status == OK)
            {
                //V(">> Q\n");
                write(fd, "Q", 1);
                uart->status = ReadFromSerial(20, uart->revision);
            }
            uart->signature_read_request = false;
            pthread_cond_signal(&(uart->cond_read_signature));
        }

        if(uart->edata_read_request)
        { 
            //V("UART : get eData\n");
            const u8 toRead[] = {'r', 0, 0, (u8)(sizeof(eeprom_data_t)%256), (u8)(sizeof(eeprom_data_t)/256)};
            //V(">> read conf\n");
            write(fd, toRead, 5);
            uart->status = ReadFromSerial(sizeof(eeprom_data_t), (u8*)&(uart->eData));
            uart->edata_read_request = false;
            pthread_cond_signal(&(uart->cond_read_edata));
        }
        
        if(uart->edata_write_request)
        { 
            //V("UART : write eData\n");
            const u8 toWrite[] = {'w', 0, 0, (u8)(sizeof(eeprom_data_t)%256), (u8)(sizeof(eeprom_data_t)/256)};
            //V(">> write new conf\n");
            write(fd, toWrite, 5);
            // Need to slow down writing to avoid buffer overflow
            int i;
            for(i=0; i < sizeof(eeprom_data_t) - 5; i+=5)
            {
                write(fd, (u8*)&(uart->eDataToWrite)+i, 5);
                SleepMs(50);
            }
            write(fd, (u8*)&(uart->eDataToWrite)+i, sizeof(eeprom_data_t) - i);
            // read back and compare 
            /*
            const u8 toRead[] = {'r', 0, 0, (u8)(sizeof(eeprom_data_t)%256), (u8)(sizeof(eeprom_data_t)/256)};
            write(fd, toRead, 5);
            res = ReadFromSerial(sizeof(eDataTmp), (u8*)&eDataTmp);
            if(res != OK) return FAIL;
            // use memcmp as structures are byte aligned (no padding)
            if(memcmp(&eDataTmp, &eDataToWrite, sizeof(eDataTmp)))
              {
            //TODO investigate
            RED("Read back eData are corrupted !");
            return FAIL;
            }*/
            uart->edata_write_request = false;
            pthread_cond_signal(&(uart->cond_write_edata));
        }

        
        pthread_mutex_unlock(&(uart->mutex_edata));
        if(uart->continuous_mode) usleep(5000);
    }

    return NULL;
}

/***** Access functions *****/

static int QueryState(uart_com_t *uart, current_data_t *gState)
{
    int res = 0;

    for(int i=0; i<RETRY_SERIAL; i++)
    {
        pthread_mutex_lock(&(uart->mutex_edata));
        // set flag and wait for reply 
        uart->curdata_read_request = true;
        pthread_cond_signal(&(uart->cond_uart_request));
        pthread_cond_wait(&(uart->cond_read_current_data), &(uart->mutex_edata));
        res = uart->status;
        if(res == OK)
        {
            memcpy(gState, &(uart->gState), sizeof(current_data_t));
            pthread_mutex_unlock(&(uart->mutex_edata));
            return OK;
        }
        pthread_mutex_unlock(&(uart->mutex_edata));
        WARN(logHandle, "Retry read gState\n");
    }
    if(res != OK) return FAIL;
    return OK;
}

static int QuerySignature(uart_com_t *uart, u8 *signature, u8 *revision)
{
    int res;

    pthread_mutex_lock(&(uart->mutex_edata));
    // set flag and wait for reply 
    uart->signature_read_request = true;
    pthread_cond_signal(&(uart->cond_uart_request));
    pthread_cond_wait(&(uart->cond_read_signature), &(uart->mutex_edata));
    res = uart->status;
    if(res == OK)
    {
        memcpy(signature, uart->signature, 32);
        memcpy(revision, uart->revision, 20);
    }
    pthread_mutex_unlock(&(uart->mutex_edata));
    if(res != OK) return FAIL;
    return OK;
}

// Read/Write retry, simulation is not 100% reliable
static int WriteConfigRetry(uart_com_t *uart, eeprom_data_t *toWrite)
{
    int retry, res;
    for(retry=0; retry < RETRY_SERIAL;retry++)
    {
        res = WriteConfig(uart, toWrite);
        if(res == OK) 
        {
            trace_writer_update_eeprom(&vcd_trace, toWrite); // trace changes
            return OK;
        }
        WARN(logHandle, "Write config retry\n");
    }
    return FAIL;
}

static int ReadConfigRetry(uart_com_t *uart, eeprom_data_t *toRead)
{
    int retry, res;
    for(retry=0; retry < RETRY_SERIAL;retry++)
    {
        res = ReadConfig(uart, toRead);
        if(res == OK) return OK;
        WARN(logHandle, "Read config retry\n");
    }
    return FAIL;
}

/***********************************************************
 ***********************************************************/

/****** Tests Cases *******/
#define CHECK_AND_PRINT(meas, expected, tolerance, text)                                                        \
        do{                                                                                                     \
        result = CheckTolerance((meas), (expected), (tolerance), &error);                                       \
        snprintf(str, 256, (text), (meas), (expected), error);                                                  \
        if(result) GREEN("%s", str); else {RED("%s", str); verdict = FAIL;}                                     \
        }while(0)                                                                                               \

#define CHECK_STATE_AND_PRINT(meas, expected)                                                                   \
        do{                                                                                                     \
        result = (meas == expected);                                                                            \
        char bufState[64];                                                                                      \
        EnginePrettyPrint((meas), bufState);                                                                    \
        snprintf(str, 256, "Engine state : 0x%X (%s)\n", (meas), bufState);                                     \
        if(result) GREEN("%s", str); else {RED("%s", str); verdict = FAIL;}                                     \
        }while(0)                                                                                               \

#define CHECK_PIN_AND_PRINT(meas, expected, text)                                                               \
        do{                                                                                                     \
        result = (meas == expected);                                                                            \
        snprintf(str, 256, (text), (meas)?"ON":"OFF");                                                          \
        if(result) GREEN("%s", str); else {RED("%s", str); verdict = FAIL;}                                     \
        }while(0)                                                                                               \


int TestStub(void)
{
    HIGH("Test bidon !\n");
    return NOTEST;
}

int TestVersion(void)
{
    /* This test aims to check serial link
       by querying the version and check
       it is correctly formated */
    char signature[33];
    char revision[21];

    int result = QuerySignature(&uart_com, (u8*)signature, (u8*)revision);
    revision[20] = '\0';
    signature[32] = '\0';

    if(result != OK)
    {
        RED("Erreur dans la lecture de la signature/revision \n");
        return FAIL;
    }

    char message[256];
    sprintf(message, "Signature :%s\nRevision : %s\n", signature, revision);
    if(strncmp(signature, "** Solextronic v0.2 **     ", 32))
    {
        GREEN("%s\n", message);
        return PASS;
    }else{
        RED("%s\n", message);
        return FAIL;
    }
    return FAIL;
}

int TestRPM(void)
{
    /* This test aims to check RPM measurement 
       it tries several RPM values and read serial
       command to get measured RPM */
    const float tolerance = 5; //%
    int subTestPassed = 0;
    int rpmTable[RPM_QTY] = {500, 2000, 4000, 6000, 10000};
    current_data_t gState;


    for (int i = 0; i < RPM_QTY; i++)
    {
        /* set new RPM */
        HIGH("RPM a %d tr/min\n", rpmTable[i]);
        uint32_t high, low;
        RPMtoPeriod(rpmTable[i], &high, &low);
        pulse_input_config(&pulse_input_engine, high, low, 0);
        SleepMs(5000);
        /* query result */
        QueryState(&uart_com, &gState);

        float error = 100 - (100. * gState.rpm / (float)rpmTable[i]);

        if(error > tolerance || error < -tolerance)
        {       
            RED("RPM mesure a %d tr/min : %d, erreur %.1f %% \n", rpmTable[i], gState.rpm, error);
        }else{
            GREEN("RPM mesure a %d tr/min : %d, erreur %.1f %% \n", rpmTable[i], gState.rpm, error);
            subTestPassed++;
        }
    }
    if(subTestPassed == RPM_QTY)
    {   
        return PASS;
    }
    return FAIL;
}


int TestSpeed(void)
{
    /* This test aims to check speed measurement 
       it tries several speed values and read serial
       command to get measured speed */

    const float tolerance = 5; //%
    int subTestPassed = 0;
    int speedTable[SPEED_QTY] = {10, 20, 40, 60, 90};
    current_data_t gState;

    for (int i = 0; i < SPEED_QTY; i++)
    {
        HIGH("Vitesse a %d km/h\n", speedTable[i]);
        /* set new speed */
        uint32_t high, low;
        SpeedtoPeriod(speedTable[i], &high, &low);
        pulse_input_config(&pulse_input_wheel, high, low, 0);
        SleepMs(5000);
        /* query result */
        QueryState(&uart_com, &gState);

        float error = 100 - (100. * (gState.speed / 10.) / (float)speedTable[i]);

        if(error > tolerance || error < -tolerance)
        {       
            RED("Vitesse mesuree a %d km/h : %.1f km/h, erreur %.1f %% \n", speedTable[i], gState.speed/10., error);
        }else{
            GREEN("Vitesse mesuree a %d km/h : %.1f km/h, erreur %.1f %% \n", speedTable[i], gState.speed/10., error);
            subTestPassed++;
        }
    }

    if(subTestPassed == SPEED_QTY)
    {   
        return PASS;
    }
    return FAIL;
}

#define ANALOG_QTY 4
int TestAnalog(void)
{
    /* This test check the analog inputs capture and conversions for 
     * temperature, TPS, MAP and battery */

    const float tolerance = 5; //%
    int subTestPassed = 0;
    float analogTable[ANALOG_QTY][5] = {{ 95,  20, 20,  1,  30},
                                        {110, 100, 25, 50,  50},
                                        {120, 120, 30, 90,  90},
                                        {150, 180, 35, 100, 100}}; // battery, CLT, IAT, TPS, MAP

    const float analogMax[5] = { 150, 150, 40,  100, 110}; // battery, CLT, IAT, TPS, MAP
    current_data_t gState;
    // Update config
    eeprom_data_t eDataToWrite;
    if(ReadConfigRetry(&uart_com, &eDataToWrite) != OK) 
    {
        RED("Impossible de lire la configuration");
        return FAIL;
    }
    eDataToWrite.battRatio  = 150;
    eDataToWrite.map0       = 0;
    eDataToWrite.map5       = 110;
    eDataToWrite.tpsMin     = 20;
    eDataToWrite.tpsMax     = 150;
    if(WriteConfigRetry(&uart_com, &eDataToWrite) != OK) return FAIL;

    // now the requests
    INFO(logHandle, "   Battery  |     CLT    |     IAT    |    TPS     |     MAP    |  TPSState\n");
    for (int i = 0; i < ANALOG_QTY; i++)
    {
        /* set new inputs values */
        float voltage[5];
        voltage[0] = BatToVoltage(analogTable[i][0]);
        voltage[1] = TempToVoltage(analogTable[i][1], CLT, &eDataToWrite);
        voltage[2] = TempToVoltage(analogTable[i][2], IAT, &eDataToWrite);
        voltage[3] = ThrToVoltage(analogTable[i][3], &eDataToWrite);
        voltage[4] = MapToVoltage(analogTable[i][4], &eDataToWrite);
        for(int j = 0; j < 5; j++)
            analog_input_set_value(&analog, j, voltage[j], 0);
        SleepMs(1000);
        /* query result */
        QueryState(&uart_com, &gState);

        /* criteria : values are correct */
        float maxError = 0.;
        int analogResult[] = {gState.battery, gState.CLT, gState.IAT, gState.TPS, gState.MAP};
        int rawResult[]    = {gState.rawBattery, gState.rawClt, gState.rawIat, gState.rawTps, gState.rawMap};
        char message[256];
        message[0] = '\0';
        for(int j = 0; j < 5; j++)
        {
            // error over the ful dynamic
            float error = 100. * (analogResult[j] - analogTable[i][j]) / analogMax[j];
            sprintf(message, "%s %2.0f%% %3d %3d|", message, error, analogResult[j], rawResult[j]);
            if(error < 0) error = -error;
            if(error > tolerance) 
            {
                maxError = error;
            }
        }
        if(maxError <= tolerance)
        {
            GREEN("%s 0x%x\n", message, gState.TPSState);
            subTestPassed++;
        }else{
            RED("%s 0x%x\n", message, gState.TPSState);
        }
    }

    if(subTestPassed == ANALOG_QTY)
    {   
        return PASS;
    }
    return FAIL;
}

/* Injection test mode
   Enable injection for 20 cycles and open time of 1000us.
   Check that injection occurs every 10ms for 1000us with no advance/open time
*/
int TestInjectionTestMode(void)
{
    int verdict = PASS;
    const u16 injDuration = 1000;
    const u16 injCycles   = 20;
    const float tolerance = 5; //%
    // 1. Disable RPM generator
    pulse_input_config(&pulse_input_engine, 0, 1000, 0);
    SleepMs(100);
	timing_analyzer_result_t result;
    timing_analyzer_result(&timing_analyzer_injection, &result); // reset stats
    // 2. Set injection parameters
    eeprom_data_t eDataToWrite;
    if(ReadConfigRetry(&uart_com, &eDataToWrite) != OK) return FAIL;
    eDataToWrite.injTestPW     = injDuration;
    eDataToWrite.injTestCycles = injCycles;
    eDataToWrite.injPolarity   = 1;
    if(WriteConfigRetry(&uart_com, &eDataToWrite) != OK) return FAIL;
   
    // 3. Measure injection signal timing
    SleepMs(20 * injCycles);
    timing_analyzer_result(&timing_analyzer_injection, &result); // read stats
	INFO(logHandle, "result.period 			%d\n",result.period);
	INFO(logHandle, "result.high_duration 	%d\n",result.high_duration);
	INFO(logHandle, "result.count 			%d\n",result.count);

    // 4. Compare to expected values
    float error = 100 - (100. * result.period / 10000);
    if(error > tolerance || error < -tolerance)
    {       
        RED("Periode mesuree : %d us, erreur %.1f %% \n", result.period, error);
        verdict = FAIL;
    }else{
        GREEN("Periode mesuree : %d us, erreur %.1f %% \n", result.period, error);
    }
    error = 100 - (100. * result.high_duration / injDuration);
    if(error > 2*tolerance || error < -2*tolerance)  // not a critical point
    {       
        RED("Temps d'injection mesure : %d us, erreur %.1f %% \n", result.high_duration, error);
        verdict = FAIL;
    }else{
        GREEN("Temps d'injection mesure : %d us, erreur %.1f %% \n", result.high_duration, error);
    }
    if(result.count != injCycles)
    {       
        RED("Nombre d'injection mesure : %d / %d \n", result.count, injCycles);
        verdict = FAIL;
    }else{
        GREEN("Nombre d'injection mesure : %d / %d \n", result.count, injCycles);
    }
    
    return verdict;
}

/* Ignition test mode
   Enable ignition with open time of 1000us.
   Check that ignition occurs every 10ms for 1000us
*/
int TestIgnitionTestMode(void)
{
    int verdict = PASS;
    const u16 ignDuration = 1000;
    const float tolerance = 5; //%
    // 1. Disable RPM generator
    pulse_input_config(&pulse_input_engine, 0, 1000, 0);
    SleepMs(1000);
	timing_analyzer_result_t result;
    timing_analyzer_reset(&timing_analyzer_ignition, 5); //reset stats, discard 5 1st cycles
    // 2. Set ignition test mode
    eeprom_data_t eDataToWrite;
    if(ReadConfigRetry(&uart_com, &eDataToWrite) != OK) return FAIL;
    eDataToWrite.PMHOffset      = 0;
    eDataToWrite.ignDuration    = ignDuration;
    eDataToWrite.ignTestMode    = 1;
    eDataToWrite.ignPolarity    = 1;
    SleepMs(100);
    if(WriteConfigRetry(&uart_com, &eDataToWrite) != OK) return FAIL;
   
    // 3. Measure ignition signal timing
    SleepMs(2000);
    timing_analyzer_result(&timing_analyzer_ignition, &result); // read stats
	V("result.period            %d\n",result.period);
	V("result.high_duration     %d\n",result.high_duration);
	V("result.count             %d\n",result.count);

    // 4. Compare to expected values
    float error = 100 - (100. * result.period / 10000);
    if(error > tolerance || error < -tolerance)
    {       
        RED("Periode mesuree : %d us, erreur %.1f %% \n", result.period, error);
        verdict = FAIL;
    }else{
        GREEN("Periode mesuree : %d us, erreur %.1f %% \n", result.period, error);
    }
    error = 100 - (100. * result.high_duration / ignDuration);
    if(error > 2*tolerance || error < -2*tolerance)  // not a critical point
    {       
        RED("Temps d'allumage mesure : %d us, erreur %.1f %% \n", result.high_duration, error);
        verdict = FAIL;
    }else{
        GREEN("Temps d'allumage mesure : %d us, erreur %.1f %% \n", result.high_duration, error);
    }
    eDataToWrite.ignTestMode    = 0;
    if(WriteConfigRetry(&uart_com, &eDataToWrite) != OK) return FAIL;
    
    return verdict;
}

/* Timing test
   For several RPM and load, check timing of injection and ignition signals
   versus the model and given injection/ignitions tables
*/
#define POINT_QTY 4

int TestIgnInjTiming(void)
{
    int verdict = PASS;
    int inputTable[POINT_QTY][6] = {{ 2000, 130, 100, 20,  1,  30},
                                    { 4000, 120, 100, 25, 50,  50},
                                    { 6000, 120, 120, 30, 90,  90},
                                    {10000, 110, 120, 35, 100, 100}}; // RPM, battery, CLT, IAT, TPS, MAP
	timing_analyzer_result_t ignResult;
	timing_analyzer_result_t injResult;
    char str[256];
    current_data_t gState;
    
    // 1. Set parameters and tables
    eeprom_data_t eDataToWrite;
    if(ReadConfigRetry(&uart_com, &eDataToWrite) != OK) return FAIL;
    eDataToWrite.ignTestMode    = 0;
    eDataToWrite.PMHOffset      = 0; // TODO : To be tested
    eDataToWrite.ignDuration    = 1000;
    eDataToWrite.ignPolarity    = 1;
    eDataToWrite.injPolarity    = 1;
    eDataToWrite.battRatio      = 150;
    eDataToWrite.map0           = 0;
    eDataToWrite.map5           = 110;
    eDataToWrite.tpsMin         = 20;
    eDataToWrite.tpsMax         = 150;
    eDataToWrite.targetAfr      = 120; // 12
    // Force running mode
    eDataToWrite.runTestMode    = 1;

    //Fill advance table
    for(int i = 0; i < TABSIZE; i++)
    {
        eDataToWrite.rpmBins[i]  = 1000 * (i+1);
        eDataToWrite.loadBins[i] = 10 * (i+1);
        for(int j = 0; j < TABSIZE; j++)
        {
            eDataToWrite.ignTable[i][j] = 4*i+j;
            eDataToWrite.injTable[i][j] = 100; // VE set to 100%
        }
    }
    if(WriteConfigRetry(&uart_com, &eDataToWrite) != OK) return FAIL;

    SetUartMode(&uart_com, true);
    for (int i = 0; i < POINT_QTY; i++)
    {
        // 2. set new RPM and sensors parameters
        HIGH("RPM %d tr/min, bat %.1fv, CLT %ddeg, IAT %ddeg, TPS %d%% MAP %dkPa\n",
                inputTable[i][0], inputTable[i][1]/10., inputTable[i][2], inputTable[i][3], inputTable[i][4], inputTable[i][5]);
        uint32_t high, low;
        RPMtoPeriod(inputTable[i][0], &high, &low);
        pulse_input_config(&pulse_input_engine, high, low, 0);
        float voltage[5];
        voltage[0] = BatToVoltage(inputTable[i][1]);
        voltage[1] = TempToVoltage(inputTable[i][2], CLT, &eDataToWrite);
        voltage[2] = TempToVoltage(inputTable[i][3], IAT, &eDataToWrite);
        voltage[3] = ThrToVoltage(inputTable[i][4], &eDataToWrite);
        voltage[4] = MapToVoltage(inputTable[i][5], &eDataToWrite);
        for(int j = 0; j < 5; j++)
            analog_input_set_value(&analog, j, voltage[j], 0);

        SleepMs(1000);
        timing_analyzer_reset(&timing_analyzer_ignition, 5);
        timing_analyzer_reset(&timing_analyzer_injection, 5);
        SleepMs(2000 * 1000/inputTable[i][0]);
        /* query result */
        QueryState(&uart_com, &gState);

        // 3. Measure signal timing
        timing_analyzer_result(&timing_analyzer_ignition, &ignResult); // read stats
        timing_analyzer_result(&timing_analyzer_injection, &injResult); // read stats
        float ignAdvance = TimingToAdvance(inputTable[i][0], ignResult.rising_offset);
        float injAdvance = TimingToAdvance(inputTable[i][0], injResult.rising_offset);
       
        // 4. Run model and get expected values
        double computedK = ComputeK(eDataToWrite.targetAfr, 100);
        double load = ComputeLoad(eDataToWrite, gState);
        res_t ignModel, injModel;
        ComputeInjection(eDataToWrite, gState, &injModel);
        ComputeIgnition(eDataToWrite, gState, &ignModel);

        // 5. Compare to expected values
        float error = 0; bool result = false;
        V("General                |  Measured  |  Expected  |  Error |\n");
        CHECK_AND_PRINT(gState.rpm, inputTable[i][0], 100, "  RPM from module      | %10d | %10d | %5.1f |\n");
        CHECK_AND_PRINT(gState.load, load, 1, "  Load from module     | %10d | %10.1f | %5.1f |\n");
        
        V("Ignition :\n");
        CHECK_AND_PRINT(ignResult.period, high+low, 100, "  Period (us)          | %10d | %10d | %5.1f |\n");
        CHECK_AND_PRINT(ignResult.high_duration, ignModel.duration, 10, "  Pulse duration (us)  | %10d | %10d | %5.1f |\n");
        CHECK_AND_PRINT(ignAdvance, ignModel.advance, 2, "  Advance from pin     | %10.1f | %10.1f | %5.1f |\n");
        CHECK_AND_PRINT(gState.advance, ignModel.advance, 2, "  Advance from module  | %10d | %10.1f | %5.1f |\n");
        V("  Count                | %10d |\n", ignResult.count);
        V("  Result.rising_offset | %10d |\n", ignResult.rising_offset);
        V("  Result.falling_offset| %10d |\n", ignResult.falling_offset);
        
        V("Injection :\n");
        CHECK_AND_PRINT(gState.injK, computedK, 1, "  K                    | %10d | %10.1f | %5.1f |\n");
        CHECK_AND_PRINT(gState.injVE, injModel.VE, 1,  "  VE                   | %10d | %10.1f | %5.1f |\n");
        CHECK_AND_PRINT(injResult.period, high+low, 100, "  Period (us)          | %10d | %10d | %5.1f |\n");
        CHECK_AND_PRINT(injResult.high_duration, injModel.duration, 10, "  Pulse dur (pin,us)   | %10d | %10d | %5.1f |\n");
        CHECK_AND_PRINT(gState.injPulseWidth, injModel.duration, 10, "  Pulse dur (module,us)| %10d | %10d | %5.1f |\n");
        CHECK_AND_PRINT(injAdvance, injModel.advance, 2, "  Start from pin(deg)  | %10.1f | %10.1f | %5.1f |\n");
        CHECK_AND_PRINT(gState.injStart, injModel.start, 10, "  Start from module(us)| %10d | %10d | %5.1f |\n");
        V("  Count                | %10d |\n", injResult.count);
        V("  Result.rising_offset | %10d |\n", injResult.rising_offset);
        V("  Result.falling_offset| %10d |\n", injResult.falling_offset);

    }
    return verdict;
}

/* Starting test
 * =============
 * For several RPM and load, check timing of injection and ignition signals
 * versus the model and given injection/ignitions tables.
 * Test procedure :
   1/ Set configuration and check inputs
   2/ Push on cranking button + start RPM generator at 500RPM : check HV enable and pump, check cranking state : advance and injection
   3/ After 5sec, set RPM at 1500RPM and check injection/advance + enrich linked to CLT and afterstart
   4/ Check engine running at idle for 30sec
   5/ Open TPS quickly and check transient behavior
   6/ Close TPS to idle quickly and check transient behavior 
   7/ Check for overheat protection : increase CLT to high value and check ignition retard + injection enrich
   8/ Check for RPM limitation : check for ignition retard if RPM goes higher than limitation 
*/

int TestStarting(void)
{
    int verdict = PASS;
	timing_analyzer_result_t ignResult;
	timing_analyzer_result_t injResult;
    char str[256];
    current_data_t gState;
    
    HIGH("Step 1 : set configuration and check inputs and outputs...\n");
    // 1.1. Set parameters and tables
    eeprom_data_t eDataToWrite;
    if(ReadConfigRetry(&uart_com, &eDataToWrite) != OK) return FAIL;
    eDataToWrite.ignTestMode    = 0;
    eDataToWrite.PMHOffset      = 0; // TODO : To be tested
    eDataToWrite.ignDuration    = 1000;
    eDataToWrite.ignPolarity    = 1;
    eDataToWrite.injPolarity    = 1;
    eDataToWrite.pumpPolarity   = 1;
    eDataToWrite.targetAfr      = 120; // 12, best power
    eDataToWrite.ignStarter     = 0;
    eDataToWrite.injStarterCold = 9000;
    eDataToWrite.injStarterWarm = 7000;
    eDataToWrite.injectorOpen   = 500;
    eDataToWrite.injectorRate   = 1400; //ug/msec
    eDataToWrite.injAdv         = 60;
    eDataToWrite.injAfterStartDur = 100; // 1000ms
    eDataToWrite.battRatio      = 150;
    eDataToWrite.map0           = 0;
    eDataToWrite.map5           = 110;
    eDataToWrite.tpsMin         = 20;
    eDataToWrite.tpsMax         = 150;
    eDataToWrite.runTestMode    = 0;

    //Fill advance and injection tables, as well as afterstart and warmup tables
    for(int i = 0; i < TABSIZE; i++)
    {
        eDataToWrite.rpmBins[i]  = 1000 * (i+1);
        eDataToWrite.loadBins[i] = 10 * (i+1);
        for(int j = 0; j < TABSIZE; j++)
        {
            eDataToWrite.ignTable[i][j] = 4*i+j;
            eDataToWrite.injTable[i][j] = 100; // VE set to 100%
        }
        eDataToWrite.injAfterStartTbl[i][0] = 0 + 10*i; //CLT
        eDataToWrite.injAfterStartTbl[i][1] = 100 - 10*i; //enrich
        eDataToWrite.injWarmupTbl[i][0] = 0 + 10*i; //CLT
        eDataToWrite.injWarmupTbl[i][1] = 200 - 20*i; //enrich
    }

    if(WriteConfigRetry(&uart_com, &eDataToWrite) != OK) return FAIL;

    // 1.2. Set external sensor and check inputs measurements
    // Battery : 12v, CLT : 20d, IAT 20d, TPS : 0%, MAP : 100kPa, RPM : 0, speed 0km/h
    float voltage[5];
    voltage[0] = BatToVoltage(120);
    voltage[1] = TempToVoltage(20, CLT, &eDataToWrite);
    voltage[2] = TempToVoltage(20, IAT, &eDataToWrite);
    voltage[3] = ThrToVoltage(0, &eDataToWrite);
    voltage[4] = MapToVoltage(100, &eDataToWrite);
    for(int j = 0; j < 5; j++)
        analog_input_set_value(&analog, j, voltage[j], 0);
    
    uint32_t high, low;
    SpeedtoPeriod(0, &high, &low);
    pulse_input_config(&pulse_input_wheel, high, low, 0);
    RPMtoPeriod(0, &high, &low);
    pulse_input_config(&pulse_input_engine, high, low, 0);
    SleepMs(1000);
    /* query result */
    QueryState(&uart_com, &gState);

    float error = 0; bool result = false;
    CHECK_AND_PRINT(gState.battery, 120, 2, "Battery : %5dv   | %5dv   | %5.1f \n");
    CHECK_AND_PRINT(gState.CLT, 20, 2,      "CLT     : %5dd   | %5dd   | %5.1f \n");
    CHECK_AND_PRINT(gState.IAT, 20, 2,      "IAT     : %5dd   | %5dd   | %5.1f \n");
    CHECK_AND_PRINT(gState.TPS,  0, 2,      "TPS     : %5d%%   | %5d%%   | %5.1f \n");
    CHECK_AND_PRINT(gState.MAP,100, 5,      "MAP     : %5dkPa | %5dkPa | %5.1f \n");
    CHECK_AND_PRINT(gState.rpm,  0, 1,      "RPM     : %5drpm | %5drpm | %5.1f \n");
    CHECK_AND_PRINT(gState.speed,0, 1,      "Speed   : %4dkm/h | %4dkm/h | %5.1f \n");
    CHECK_STATE_AND_PRINT(gState.engineState, 0x0);

    // Pump (PD7), HV (PD5), ignition (PB1), injector (PB2) states : they shall be off
    output_t state = GetOutputState(NULL);
    CHECK_PIN_AND_PRINT(state.pumpPin, 0, "Pump      : %s\n");
    CHECK_PIN_AND_PRINT(state.hvPin,   0, "HV        : %s\n");
    CHECK_PIN_AND_PRINT(state.ignPin,  0, "Ignition  : %s\n");
    CHECK_PIN_AND_PRINT(state.injPin,  0, "Injection : %s\n");
   
    if(verdict == FAIL) return verdict; 

    // 2.1. Push on cranking button + start RPM generator at 500RPM : check HV enable and pump, check cranking state : advance and injection
    HIGH("Step 2 : Start cranking. Check pump/injection/ignition behavior\n");
    button_press(&button_cranking);
    RPMtoPeriod(500, &high, &low);
    pulse_input_config(&pulse_input_engine, high, low, 0);
    SleepMs(1000);
    
    QueryState(&uart_com, &gState);
    CHECK_STATE_AND_PRINT(gState.engineState, 0x1);
    state = GetOutputState(NULL);
    CHECK_PIN_AND_PRINT(state.pumpPin, 1, "Pump      : %s\n");
    CHECK_PIN_AND_PRINT(state.hvPin,   1, "HV        : %s\n");
    timing_analyzer_reset(&timing_analyzer_ignition, 5);
    timing_analyzer_reset(&timing_analyzer_injection, 5);
    SleepMs(1000);
    /* query result */
    QueryState(&uart_com, &gState);

    // 2.2. Measure signal timing
    timing_analyzer_result(&timing_analyzer_ignition, &ignResult); // read stats
    timing_analyzer_result(&timing_analyzer_injection, &injResult); // read stats
    float ignAdvance = TimingToAdvance(500, ignResult.rising_offset);
    float injAdvance = TimingToAdvance(500, injResult.rising_offset);
    double computedK = ComputeK(eDataToWrite.targetAfr, gState.MAP);
    V("General                |  Measured  |  Expected  |  Error |\n");
    CHECK_AND_PRINT(gState.rpm, 500, 20, "  RPM from module      | %10d | %10d | %5.1f |\n");
    CHECK_AND_PRINT(gState.load, 0., 1, "  Load from module     | %10d | %10.1f | %5.1f |\n");

    V("Ignition :\n");
    CHECK_AND_PRINT(ignResult.high_duration, eDataToWrite.ignDuration, 10, "  Pulse duration (us)  | %10d | %10d | %5.1f |\n");
    CHECK_AND_PRINT(ignAdvance, eDataToWrite.ignStarter, 2, "  Advance from pin     | %10.1f | %10d | %5.1f |\n");
    CHECK_AND_PRINT(gState.advance, eDataToWrite.ignStarter, 2, "  Advance from module  | %10d | %10d | %5.1f |\n");
    V("  Count                | %10d |\n", ignResult.count);
    V("  Result.rising_offset | %10d |\n", ignResult.rising_offset);
    V("  Result.falling_offset| %10d |\n", ignResult.falling_offset);

    V("Injection :\n");
    CHECK_AND_PRINT(gState.injK, computedK, 10, "  K                    | %10d | %10.1f | %5.1f |\n");
    CHECK_AND_PRINT(injResult.high_duration, eDataToWrite.injectorOpen+eDataToWrite.injStarterCold, 10, "  Pulse dur (pin,us)   | %10d | %10d | %5.1f |\n");
    CHECK_AND_PRINT(gState.injPulseWidth, eDataToWrite.injectorOpen+eDataToWrite.injStarterCold, 10, "  Pulse dur (module,us)| %10d | %10d | %5.1f |\n");
    CHECK_AND_PRINT(injAdvance, eDataToWrite.injAdv, 2., "  Start from pin(deg)  | %10.1f | %10d | %5.1f |\n");
    CHECK_AND_PRINT(gState.injStart, eDataToWrite.injAdv, 10, "  Start from module(us)| %10d | %10d | %5.1f |\n");
    V("  Count                | %10d |\n", injResult.count);
    V("  Result.rising_offset | %10d |\n", injResult.rising_offset);
    V("  Result.falling_offset| %10d |\n", injResult.falling_offset);

    //FIXME if(verdict == FAIL) return verdict; 
    
    // 3. After 5sec, set RPM at 1500RPM and check injection/advance + enrich linked to CLT and afterstart
    HIGH("Step 3 : engine is starting. Set RPM to 1500rpm in 2 sec and start CLT ramp for 30sec\n");
    analog_input_set_value(&analog, 1, TempToVoltage(120, CLT, &eDataToWrite), 30000);
    RPMtoPeriod(1500, &high, &low);
    pulse_input_config(&pulse_input_engine, high, low, 2000);
    for(int i=0; i<300; i++)
    {
        SleepMs(100);
        QueryState(&uart_com, &gState);
        DBG(logHandle, "Time %d, state %x, CLT %d, RPM %d, AfterStart %d%%, warmup %d%%, total %d%%, VE %d, QFuel %d, pulse %dus\n", i, gState.engineState, gState.CLT, gState.rpm, gState.injAfterStartEnrich, gState.injWarmupEnrich, gState.injTotalEnrich, gState.injVE, gState.injQFuel, gState.injPulseWidth);
    }

    // 4. Check engine running at idle for 30sec
    // 5. Open TPS quickly and check transient behavior
    // 6. Close TPS to idle quickly and check transient behavior 
    // 7. Check for overheat protection : increase CLT to high value and check ignition retard + injection enrich
    // 8. Check for RPM limitation : check for ignition retard if RPM goes higher than limitation 
    return verdict;
}



/************** Core thread **********************/
static void *avr_run_thread(void * oaram)
{
    while (1) {
        int state = avr_run(avr);
        if ( state == cpu_Done || state == cpu_Crashed)
        {
            RED("fin du thread state = %d\n", state);
            break;
        }
    }
    return NULL;
}
/************** End Core thread **********************/

/* Print help an exit with exit code exit_msg */
static void printHelp(FILE *stream, int exitMsg, const char* progName)
{
    fprintf(stream,"usage : %s [options] elfFile\n", progName);
    fprintf(stream,"Les options valides sont :\n");
    fprintf(stream,
            "  -h\t\t affiche ce message\n"
            "  -m\t\t mode manuel\n"
            "  -v\t\t mode verbose\n"
            "  -w\t\t capture waveform dans wave.vcd\n"
            "  -l\t\t liste des tests disponibles\n"
            "  -a\t\t lancement de tous les tests\n"
            "  -t <test>\t\t lancement du test <test>\n"
            "  -r <nbRetry>\t\t nombre de retry en cas de fail. 0 par defaut\n"
           );
    exit(exitMsg);
}

/********* Main ************/
int main(int argc, char *argv[])
{
    char elfName[256], testName[256];
    /* read command-line arguments */
    int c;
    int mode = LIST_TEST;
    int retry = 0;

    opterr = 0;
    if(argc == 1)
    {
        printHelp(stdout, EXIT_SUCCESS, argv[0]);
    }
    while ((c = getopt (argc, argv, "hvlmawr:t:")) != -1)
    {
        switch (c)
        {
            case 'h': // help
                printHelp(stdout, EXIT_SUCCESS, argv[0]);
                break;
            case 'l': // list of available tests
                for(int i = 0; i < TEST_QTY; i++)
                {
                    printf("Test id %d : %s\n", testList[i].id, testList[i].name);
                }
                exit(EXIT_SUCCESS);
                break;
            case 'v': // verbose mode
                _verbose = true;
                break;
            case 'w': // verbose mode
                _wave = true;
                break;
            case 'm': // manual mode
                mode = MANUAL;
                break;
            case 'a': // run all tests
                mode = ALL_TEST;
                break;
            case 't': // run test <test>
                mode = ONE_TEST;
                strncpy(testName, optarg, 256);
                break;
            case 'r': // number of retry, 0 by default
                retry = atoi(optarg);
                break;
            case '?':
                if (optopt == 't')
                    fprintf (stderr, "Option -%c requires an argument.\n", optopt);
                else
                    fprintf (stderr, "Unknown option `-%c'.\n", optopt);
                printHelp(stderr, EXIT_FAILURE, argv[0]);
            default:
                abort();
        }
    }
    if((optind == argc) || (argc - optind > 1))
    {
        fprintf (stderr, "ELF file is mandatory !\n");
        printHelp(stderr, EXIT_FAILURE, argv[0]);
    }
    strncpy(elfName, argv[optind], 256);
    
    logger_init(TO_STDOUT, NULL);
    logHandle = logger_register("Main", COLOR_AUTO, LOGGER_DBG);

    elf_firmware_t f;
    const char * fname = "../solextronic.elf";
    elf_read_firmware(fname, &f);

    strcpy(f.mmcu, "atmega328");
    f.frequency = 16000000;
    f.vcc  = 5000;
    f.avcc = 5000;
    f.aref = 5000;
    avr = avr_make_mcu_by_name(f.mmcu);
    if (!avr) {
        fprintf(stderr, "%s: AVR '%s' not known\n", argv[0], f.mmcu);
        exit(1);
    }
    DBG(logHandle, "firmware %s f=%d mmcu=%s\n", fname, (int) f.frequency, f.mmcu);

    avr_init(avr);
    avr_load_firmware(avr, &f);
    /*if(_verbose) 
    {   
        avr->log = LOG_TRACE;
    }
    for(int i=0; i <f.symbolcount; i++)
    {
        DBG(logHandle, "Symbole %i : addr 0x%x : %s\n", i, f.symbol[i]->addr, f.symbol[i]->symbol);
    }*/ 

    /* External parts connections */
    INFO(logHandle, "Initialize external parts simulation...\n");
    uart_pty_init(avr, &uart_pty);
    uart_pty_connect(&uart_pty, '0');
    uint32_t tHigh, tLow;
    RPMtoPeriod(0, &tHigh, &tLow);
    pulse_input_init(avr, &pulse_input_engine, "Engine", 0/*tHigh*/, tLow);
    SpeedtoPeriod(0, &tHigh, &tLow);
    pulse_input_init(avr, &pulse_input_wheel, "Wheel", tHigh, tLow);
    avr_connect_irq(pulse_input_engine.irq + IRQ_PULSE_OUT, avr_io_getirq(avr, AVR_IOCTL_IOPORT_GETIRQ('D'), 2));
    avr_connect_irq(pulse_input_wheel.irq  + IRQ_PULSE_OUT, avr_io_getirq(avr, AVR_IOCTL_IOPORT_GETIRQ('D'), 3));
    int   adc_input[5] = {ADC_IRQ_ADC1, ADC_IRQ_ADC3, ADC_IRQ_ADC6, ADC_IRQ_ADC2, ADC_IRQ_ADC7}; 
    float adc_value[5] = {1, 1, 1, 1, 1}; 
    analog_input_init(avr, &analog, 5, adc_input, adc_value);
    timing_analyzer_init(avr, &timing_analyzer_injection, "Injection");
    avr_connect_irq(avr_io_getirq(avr, AVR_IOCTL_IOPORT_GETIRQ('D'), 2), timing_analyzer_injection.irq + IRQ_TIMING_ANALYZER_REF_IN);
    avr_connect_irq(avr_io_getirq(avr, AVR_IOCTL_IOPORT_GETIRQ('B'), 2), timing_analyzer_injection.irq + IRQ_TIMING_ANALYZER_IN);
    timing_analyzer_init(avr, &timing_analyzer_ignition, "Ignition");
    avr_connect_irq(avr_io_getirq(avr, AVR_IOCTL_IOPORT_GETIRQ('D'), 2), timing_analyzer_ignition.irq + IRQ_TIMING_ANALYZER_REF_IN);
    avr_connect_irq(avr_io_getirq(avr, AVR_IOCTL_IOPORT_GETIRQ('B'), 1), timing_analyzer_ignition.irq + IRQ_TIMING_ANALYZER_IN);
    button_init(avr, &button_cranking, BUTTON_NORMAL, "Crancking_btn");
    avr_connect_irq(button_cranking.irq + IRQ_BUTTON_OUT, avr_io_getirq(avr, AVR_IOCTL_IOPORT_GETIRQ('D'), 4));
    
    
    /**** Manual mode ****/
    if(mode == MANUAL)
    {
        if(_wave)
        {
            /* VCD files */
            avr_vcd_init(avr, "wave.vcd", &vcd_file, 1000 /* usec */);
            avr_vcd_add_signal(&vcd_file,
                    avr_io_getirq(avr, AVR_IOCTL_IOPORT_GETIRQ('B'), 5),
                    1 /* bits */, "LED");
            avr_vcd_add_signal(&vcd_file,
                    avr_io_getirq(avr, AVR_IOCTL_IOPORT_GETIRQ('B'), 6),
                    1 /* bits */, "Image");

            avr_vcd_add_signal(&vcd_file, pulse_input_engine.irq + IRQ_PULSE_OUT, 1, "Pulse_engine");
            avr_vcd_add_signal(&vcd_file, pulse_input_wheel.irq  + IRQ_PULSE_OUT, 1, "Pulse_Wheel");
            avr_vcd_start(&vcd_file);
        }

        pthread_t run, uart;
        pthread_create(&run, NULL, avr_run_thread, NULL);
        pthread_create(&uart, NULL, uart_thread, (void*)&uart_com);
        int speed = 0, rpm = 1000;
        
        while(1)
        {
            sleep(1);
            for(int j = 0; j < 4; j++)
            {
                adc_value[j] += 0.1; 
                if(adc_value[j] > 5) adc_value[j] = 0.0;
                analog_input_set_value(&analog, j, adc_value[j], 0);
            }
            uint32_t high, low;
            if(speed++ > 100) speed = 0;
            SpeedtoPeriod(speed, &high, &low);
            pulse_input_config(&pulse_input_wheel, high, low, 0);
            if((rpm += 100) > 10000) rpm = 1000;
            RPMtoPeriod(rpm, &high, &low);
            pulse_input_config(&pulse_input_engine, high, low, 0);
        }
        return 0;
    }

    /**** Automatic mode ****/
    // start AVR core
    if(_wave)
    {
        /* VCD files */
        avr_vcd_init(avr, "wave.vcd", &vcd_file, 1000);
        avr_vcd_add_signal(&vcd_file,
                avr_io_getirq(avr, AVR_IOCTL_IOPORT_GETIRQ('B'), 5),
                1, "LED");
        avr_vcd_add_signal(&vcd_file,
                avr_io_getirq(avr, AVR_IOCTL_IOPORT_GETIRQ('D'), 2),
                1, "RPM");
        avr_vcd_add_signal(&vcd_file,
                avr_io_getirq(avr, AVR_IOCTL_IOPORT_GETIRQ('B'), 2),
                1, "INJ");
        avr_vcd_add_signal(&vcd_file,
                avr_io_getirq(avr, AVR_IOCTL_IOPORT_GETIRQ('B'), 1),
                1, "IGN");
        avr_vcd_add_signal(&vcd_file,
                avr_io_getirq(avr, AVR_IOCTL_IOPORT_GETIRQ('D'), 4),
                1, "BTN");
        avr_vcd_add_signal(&vcd_file, pulse_input_wheel.irq  + IRQ_PULSE_OUT, 1, "Pulse_Wheel");
        avr_vcd_add_signal(&vcd_file,
                helpers_register_16bit_irq(avr, 0x88, "OCR1A"), 16, "OCR1A");
        avr_vcd_add_signal(&vcd_file,
                helpers_register_16bit_irq(avr, 0x8A, "OCR1B"), 16, "OCR1B");
        avr_vcd_add_signal(&vcd_file,
                helpers_register_16bit_irq(avr, 0x84, "TNCT1"), 16, "TCNT1");
        avr_vcd_add_signal(&vcd_file,
                helpers_register_debug_irq(avr, 0xFE, "DEBUG1", 16), 16, "DEBUG1");
        avr_vcd_add_signal(&vcd_file,
                helpers_register_debug_irq(avr, 0xFC, "DEBUG2", 16), 16, "DEBUG2");
        avr_vcd_add_signal(&vcd_file,
                helpers_register_debug_irq(avr, 0xFA, "DEBUG3", 16), 16, "DEBUG3");
        avr_vcd_add_signal(&vcd_file,
                avr_iomem_getirq(avr, 0x4E, "SPDR", 8), 8, "DEBUG");
        avr_vcd_add_signal(&vcd_file,
                avr_iomem_getirq(avr, 0x4D, "SPSR", 8), 8, "PARAM");
        avr_vcd_start(&vcd_file);

        // trace file : to trace eData and curData
        trace_writer_init(avr, "trace.vcd", &vcd_trace, 1000, NULL, 0);
        trace_writer_start(&vcd_trace, &(uart_com.eData), &(uart_com.gState));  
    }
    
    pthread_t run, uart;
    pthread_create(&run, NULL, avr_run_thread, NULL);
    pthread_create(&uart, NULL, uart_thread, (void*)&uart_com);
    SleepMs(1000); 
    // Connection to serial port
    fd = SerialOpen();
    button_release(&button_cranking);
    avr_raise_irq(avr_iomem_getirq(avr, 0x4E, "SPDR", 8), 0xBB);
    
    SleepMs(1000);
    if(mode == ONE_TEST)
    {
        int testId = 0;
        /* get id of the requested test */
        for(int i = 0; i < TEST_QTY; i++)
        {
            if(strcmp(testName, testList[i].name) == 0){
                testId = i;
                break;
            }
        }   
        //run test
        int retryCount = retry;
        do{
            HIGH("Lancement test %d : %s...\n", testList[testId].id, testList[testId].name);
            int res = (testList[testId].testFunction)();
            if(res == PASS)
            {
                GREEN("Bravo : test OK !\n");
                break;
            }
            else if(res == FAIL)
            {
                RED("Test KO :-(\n");
            }else{
                HIGH("Not run\n");
                break;
            }  
        }while((retryCount--) > 0);
    }
    else if(mode == ALL_TEST)
    {
        int testPassed = 0;
        for(int i = 0; i < TEST_QTY; i++)
        {
            int retryCount = retry;
            do{
                HIGH("Lancement test %d : %s...\n", testList[i].id, testList[i].name);
                int res = (testList[i].testFunction)();
                if(res == PASS)
                {
                    testPassed++;
                    GREEN(" Verdict %s PASS\n", testList[i].name);
                    break;
                }
                else if(res == NOTEST)
                {
                    testPassed++;
                    GREEN(" Verdict %s SKIP\n", testList[i].name);
                    break;
                }else{
                    RED(" Verdict %s FAIL\n", testList[i].name);
                }
            }while((retryCount--) > 0); 
        }
        if(testPassed == TEST_QTY)
        {
            GREEN("Bravo : tous les tests sont OK !\n");
        }else{

            RED("Seulement %d tests sur %d sont OK :-(\n", testPassed, TEST_QTY);
        }   
    }
    avr_vcd_stop(&vcd_file);
    trace_writer_stop(&vcd_trace);
    SerialClose(fd);
    return 0;
}
