TiboLGH/solextronic/(commit log)

2012-10-21 Ajout des pages liens et toDo List
2012-10-21 Makefile issue de OpenSilicium #2
2012-10-23 Qques liens de plus
2012-10-23 1er main, simple echo UART 57600
2012-11-04 Page wiki sur le schema : Tableau d'affectation des broches Arduino
2012-11-18 Revision de la roadmap
2012-11-18 Service timer software + interpreteur de commande basique
2013-01-15 Support des acquisitions analogiques
2013-01-17 integration revision fossil dans le numero de version
2013-06-16 DOC - Ajout du signal de rotation de la roue
2013-06-23 DOC - Affectation des ADC
2013-06-23 Gestion PWM alimentation HT et boucle d'asservissement
2013-07-01 FW - arguments de sendToUart...
2013-07-02 FW - Declenchement de l'envoie du buffer TX
2013-07-02 SIM - Ajout des parts pulse_input et UART
2013-07-07 SIM - Ajout des options de la ligne de commande + makefile simulation
2013-07-10 FW - Mesure de du regime
2013-07-10 FW - Mesure de la vitesse
2013-07-13 SIM - Ajout des composants analog, timing analyzer et HT_supply
2013-07-13 DOC - Ajout de la page simulation
2013-07-14 HW - Fichiers schema (vide)
    [solextronic.sch]
2013-07-14 FW - Ajout des licenses
2013-07-18 DOC - Ajout PWM injecteur
2013-07-19 SIM - Ajout des entrees analogiques
2013-07-19 DOC - Clean de l'accueil
2013-07-28 DOC - Mise a jour des commandes
2013-07-30 FW - Gestion de l'EEPROM
2013-09-22 FW - fix sur la mesure de basses vitesses
    [platform.c, simMain.c]
2013-10-21 DOC - Suppression de la doc dans le repo principal. Tout est dans solextronic.wiki
2013-11-01 FW - Gestion des ADC + tests en simu. Conversions faites en tache de fond, next step les passer sous interruption
2013-11-01 FW - Changement du numero de version de Fossil a Git
2013-11-02 FW - Ajout des commandes injection et allumage
2013-11-04 FW - Initialisation de l'EEPROM depuis la flash
2013-11-04 FW - Define pour les feignassses
2013-11-04 FW - Fix sur l'initialisation de l'EEPROM. Tests OK
    [main.c, platform.c, platform.h, simMain.c]
2013-11-11 HW - Schema de la carte de test externe
    [testBoard.sch]
2013-11-11 HW - PDF et png du schema de la testboard
2013-11-19 COMP - commit initial du calculateur de timings injection et allumage
    [ignition.csv, injection.csv]
2013-11-24 SCH - Debut schema de la carte principale. Modification du faisceau et de la carte de test
    [solextronic.sch, testBoard.sch]
2013-11-24 FW - changement de l'entree ADC pour la batterie. Attention, bug detecte dans simavr sur l'ADC7...
    [analog_input.c, platform.c, platform.h, simMain.c]
2013-12-03 COMPUTATION - lecture des tables d'allumage et d'injection
    [ignition.csv, injection.csv]
2013-12-03 HW - Mise a jour du schema de la carte principale
    [solextronic.sch]
2013-12-04 FW - Issue 1 : gestion des assert. Sortie sur le port serie
    [command.c, common.h, platform.c]
2013-12-05 COMPUTATION - traduction des commentaires en francais : les commentaires du code permettront de generer la doc
2013-12-09 MODEL - renommage du repertoire
    [ignition.csv, injection.csv]
2013-12-17 FW - Mise a jour de la variable d'etat interne. Va servir de base pour l'integration avec TunerStudio
2013-12-19 FW - Modifications pour supporter le protocole serie de TunerStudio
2014-01-01 SIM - Adaptation des tests de simu au nouveau protocole serie
2014-01-02 MODEL - mode de calcul du debit d'injecteur
2014-01-02 TUNER - Version initial du fichier de configuration de TunerStudio
2014-03-10 Model - calcul du timing d'allumage
    [ignition.csv]
2014-03-12 FW - ajout gestion des signaux allumage et injection
2014-03-12 FW - Test : mode verbose, debut du test injection, provision de l'ensemble des tests
2014-03-13 FW - un peu de menage
2014-03-16 SCH - Passage au DB25
    [solextronic.sch, testBoard.sch]
2014-03-16 SCH - script pour convertir les schemas en png et pdf et resultats
2014-04-20 HW - Ajout Alimemtation HT et controle de l'allumage
    [DCDC.sch, solextronic.sch]
2014-04-20 HW - Sorties PNG et PDF de l'alimentation HT
    [DCDC.sch]
2014-04-21 HW - PCB du bloc CDI
    [DCDC.brd, DCDC.sch]
2014-06-16 FW - Mode de test injection : banc de test (partie 1)
2014-06-22 FW - Ajout mode de test injection
2014-06-30 FW - Ajout du mode test d'allumage : allumage toutes les 10ms
2014-07-01 TEST - Ajout du parametre retry pour relancer les tests fail. Utile pour les campagnes auto, la liaison serie virtuelle est parfois instable
    [simMain.c]
2014-07-01 TEST - Typo sur le code de retry
2014-07-26 FW : support de la table d'avance a l'allumage. Attention, le support du timing d'injection est casse
2014-07-27 FW : conversion de l'injection au timer1 free-running
2014-08-05 HW - Modification de la taille du bloc CDI pour passer dans un format 60 x 100mm
    [DCDC.brd]
2014-11-02 [SIM] Retry sur les ecritures UART
2014-11-02 HW - 1er jet du PCB principal. Attention, modification du pinout des connecteurs
    [solextronic.kicad_pcb, solextronic.sch]
2014-11-08 FW - amelioration de Mr Propre
2014-11-25 Adaptation du makefile pour simAvr (a revoir) et fix sur les retry
    [simMain.c]
2014-12-02 HW - Renommage des signaux et mise à jour carte de test
    [solextronic.kicad_pcb, solextronic.sch, testBoard.sch]
2014-12-04 FW - Changement des noms des signaux de temperature/pression/accelerateur
2014-12-09 HW - Modification du pinout connecteur CDI. Attention PCB pas a jour !
    [DCDC.sch]
2014-12-09 HW - Debut optim carte principale
    [solextronic.kicad_pcb, solextronic.sch]
2014-12-09 HW - Modification du pinout connecteur CDI : Mise a jour PCB
    [DCDC.brd]
2014-12-12 HW - Simplification des entrees
    [solextronic.kicad_pcb, solextronic.sch]
2014-12-13 SIM - SleepMs est maintenant sysnchronise avec la simulation
2015-02-11 FW - la version dans la signature est lue depuis le fichierversion
2015-02-16 TEST - Issue 7 : script de tests automatique. A deployer sur un serveur d'integration continue du pauvre
2015-02-17 FW - Correction sur l'affichage de la version
    [command.c]
2015-03-01 FW - Gestion des conversions ADC. A tester
2015-03-16 HW - Ajout alimention variable sur la carte de test
    [testBoard.sch]
2015-03-29 HW - mise a jour du schema principale : simplification pour supprimer le bluetooth
    [solextronic.kicad_pcb, solextronic.sch]
2015-03-29 README a la sauce GitHub
2015-04-08 HW - Mise a jour de la carte de test
    [testBoard.sch]
2015-04-24 FW : Script de mise a jour automatique des fichiers documentation et tuner studio a partir de vardef.h. Part 1
2015-04-28 HW - testBoard ajout du PIC
    [testBoard.sch]
2015-04-30 FW : Script de mise a jour automatique des fichiers documentation et tuner studio a partir de vardef.h. Part 2
2015-05-08 TestBoard - mise a jour schema et soft PICavec fix pour le pb de reentrance
    [testBoard.sch]
2015-05-21 LCD - Correction driver LCD et menu
    [frontpanel.c, frontpanel.h]
2015-05-21 FW - Clean debug pour ne pas interferer avec l'I2C
    [main.c]
2015-05-21 HW - Correction schema principal et carte stim pour avoir l'alim 12v
    [DCDC.sch, solextronic.sch, testBoard.sch]
2015-05-24 FW - Remap des entrees ADC + argument pour les conversions
2015-05-24 FW - ADC correction gestion interruption, test OK
    [main.c, platform.c, platform.h]
2015-06-14 HW - Testboard : changement LED de visu
    [testBoard.sch]
2015-06-14 FW - Offset de 0.7v pour la tension batterie
2015-06-14 FW - Chrono : tests et fix mineur
    [chrono.c, frontpanel.c]
2015-06-14 FW - Front panel : anti-rebond des btn
2015-06-22 FW - Gestion de l'inection/allumage au demarrage
2015-07-06 FW - issue #18 : gestion des min/max TPS
    [platform.c, varDef.h]
2015-07-06 FW - Initialisation des tables en EEPROM
2015-07-12 FW - issue #18 : detection ralenti/plein gaz
    [common.h, main.c, platform.c, varDef.h]
2015-07-12 FW - issue #21 : gestion de la pompe a essence
    [main.c, platform.h]
2015-07-12 README - mise a jour light de la page d'accueil
2015-07-12 FW - Issue #10 : gestion de la pompe a essence
    [command.c, common.h, main.c, platform.c, varDef.h]
2015-07-13 FW - issue #15 support partiel de l'alim HT
    [main.c, platform.c, platform.h]
2015-07-15 SIM - reparation de la compil de la simu. Simu toujours cassee au passage
2015-07-19 FW / HW - Nettoyage de la gestion des IOs dans le FW et le schema
    [solextronic.sch]
2015-07-27 FW - Facteur de correction sur la tension de la batterie
    [platform.c]
2015-07-27 FW - Modification des variables bitfield
2015-08-05 On attaque la version 0.3
2015-08-09 FW - Issue #26 : relecture de l'EEPROM au boot
    [main.c, platform.c]
2015-08-09 FW - Issue #25 : gestion du define SIM
    [frontpanel.c, main.c]
2015-10-24 HW - Correction sur le generateur haute-tension. PCB a revoir
    [DCDC.sch]
2015-11-22 FW - Calcul de l'injection, partie 1
2015-12-07 SIM - Reparation du test des entrees analogiques
2015-12-19 SIM - Correction test RPM. Attention, necessite un patch sur simavr !
    [platform.c, pulse_input.c, simMain.c]
2016-05-14 SIM - Ajout des rampes sur valeurs analogiques et pulses
2016-06-05 SIM - Issue #33 : fichiers VCD et CSV sur les structures eData et gState
    [chrono.c, command.c, frontpanel.c, main.c, model.c, platform.c, simMain.c, trace_writer.c]
2016-06-05 SIM : fichiers sim_helpers oublies : amelioration des fonctions de traces de simavr
2016-06-13 SIM - Issue #35 Gestion UART dans un thread separe. Fix sur le fichier VCD
    [simMain.c, trace_writer.c]
2016-06-13 FW - Correction du champs _second_
    [command.c]
2016-09-18 SIM - Desactive les logs sur les traces VCD
2016-09-21 SIM - Part 1 du test starting : divers fix, amorce part 2
    [analog_input.c, platform.c, pulse_input.c, push_button.c, push_button.h, simMain.c]
2016-09-21 SIM - correction sur le generateur de pulse en cas de stop/start
    [pulse_input.c]
2016-09-22 SIM - Fix sur les variables bits pour le fichier de description
2016-10-16 SIM - Support des rampes sur les entrees analogiques
2016-10-16 SIM - Gestion de la polarite du push button
2016-10-16 FW - attente de 5 cycles avant de calculer un RPM
2016-12-14 SIM - Correction sur la gestion de rampe pulse input
    [pulse_input.c]
2016-12-14 FW - Fix gestion du moteur cale
    [common.h, main.c, platform.c]
2016-12-14 SIM - Part 3 du test starting : divers fix
    [simMain.c]
2016-12-27 SIM - Issue #37 : premier jet
    [logger.c, logger.h]
2016-12-30 SIM - Issue #37 : ajout d'un module de log centralise. Push_button convertit, les autres a venir
    [logger.c, logger.h, push_button.c, push_button.h, simMain.c]
2017-01-08 FW - Correction calcul injection - ajout gestion du temps d'injection au demarrage en fct de la temperature - correction des conversions injector rate
    [helper.c, helper.h, main.c, model.c, platform.c, simMain.c, varDef.h]
2017-01-08 Model - ajout spreadsheet de base
    [analyze.ods]
